alephobjects/taz-toolhead-kanyu/flexystruder/images/OHAI/IMG_0171.JPG

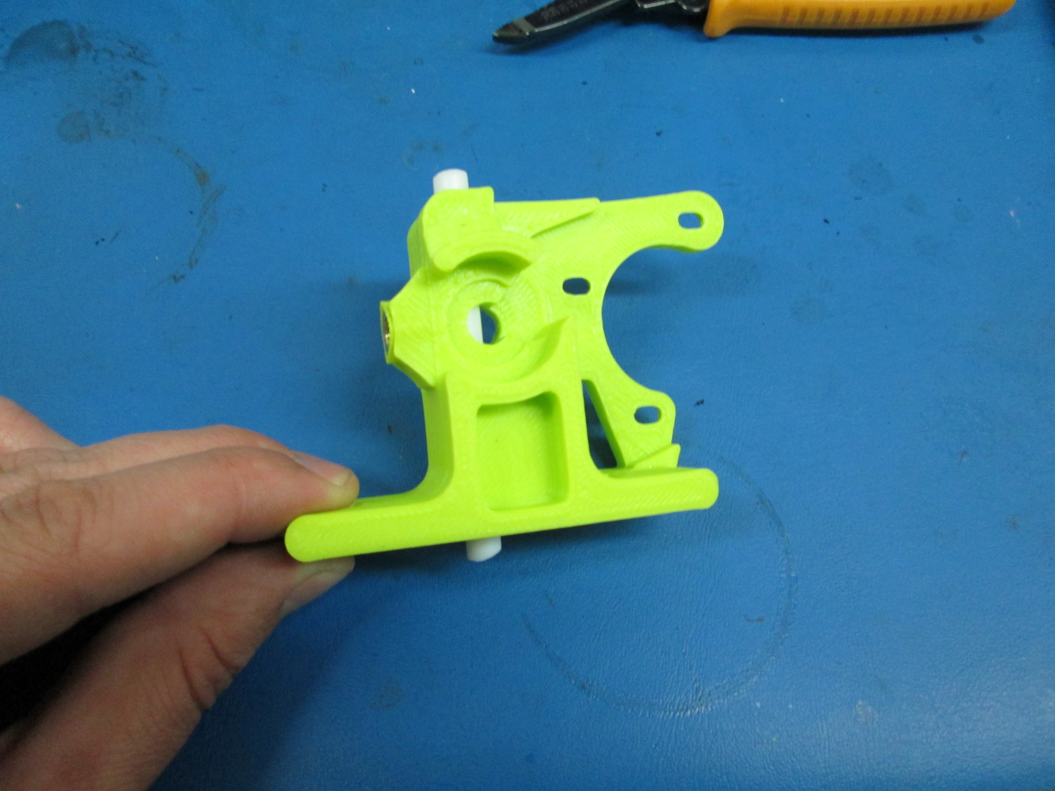
flexystruder/images/OHAI/IMG_0171.JPG
