alephobjects/taz-toolhead-kanyu/flexystruder/images/OHAI/IMG_0003.JPG.600x0_q85.jpg

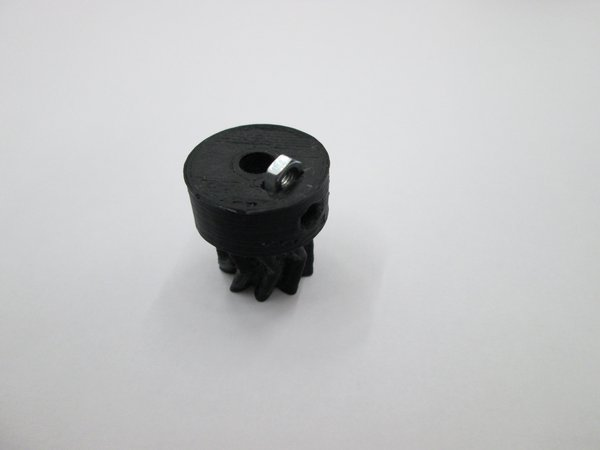
flexystruder/images/OHAI/IMG_0003.JPG.600x0_q85.jpg
