alephobjects/taz-toolhead-kanyu/production_docs/flexy_redesign_status.odt

Flexystruder redesign status

3/17/2015

Largely due to the decreased length of the melt zone between the Budashnozzle and the AO-hex, the flexystruder with the AO hexagon is only capable of printing about half as fast as the original flexystruder. For most materials the AO-hex's melt zone is long enough if the print temperatures are bumped up, but Ninjaflex presents health concerns at temperatures above 230C. Other flexible materials like Polyflex that allow for

Testing has been done on several ways to improve this speed discrepancy so that we don't release a new version that is inferior to the original. See the table below for the comparative printing speeds of the 4 options.

Flexystruder type | Maximum Speed
Budashnozzle based (current product) | 3.75 mm^3/s
Standard 0.5mm AO-Hexagon based | 1.80 mm^3/s
0.5mm AO-Hexagon with 10mm longer heater block | 3.75 mm^3/s
AO-Hexagon with 0.6mm nozzle | 3.15 mm^3/s

Option 1

We continue with the budaschnozzle as the default nozzle for the flexystruder. This would be the simplest answer, but would lead to complications for the flexydually, as the Buda and the hexagon are significantly different lengths. We could either offer the flexydually as it currently is (with a metal flex plate stiffener, or with 2 hexagons and decrease the speeds in the profiles to match.

Option 2

We could release the flexystruder with the standard 0.5mm nozzle AO-hexagon and make profiles to deal with the decerased ninjaflex printing ability. Getting polyflex on board will help a lot, we can print it 2-3X as fast as the full TPU filaments.

Option 3

We could make a new heater block and nozzle to extend the melt zone of AO-hex to the same length as the budashnozzle. This with a standard extruder could double as an E3D Volcano style hotend for large nozzle printing. Early tests showed that adding 10mm to the heater block of the AO-Hex will allow us to print at the same speeds as our current flexystruder.

Option 4

We could simply enlarge the nozzle of the AO-Hex to 0.6 (or larger). This decreases the melt and force requirements for printing TPU enough to almost match the current flexystruder in printing speed. This will decrease our minimum feature size in x and y slightly, but it would greatly increase the speed that we could print materials like polyflex with.
