alephobjects/taz-toolhead-kanyu/flexystruder/images/IMG_2415.JPG

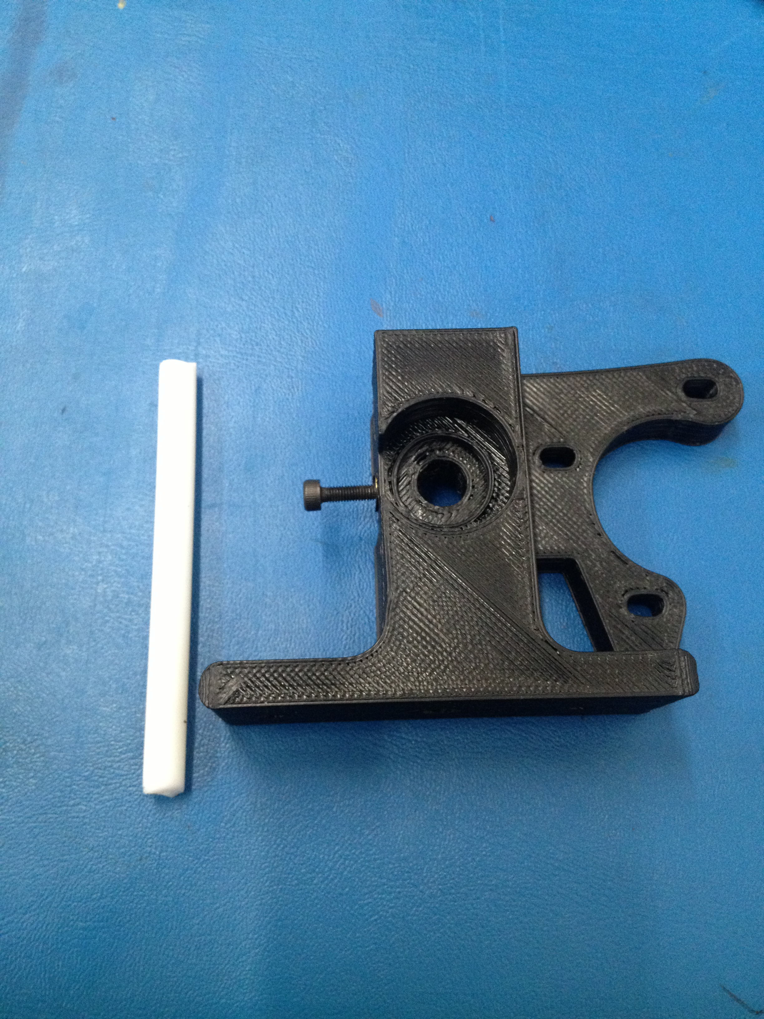
flexystruder/images/IMG_2415.JPG
