alephobjects/taz-toolhead-kanyu/flexystruder/images/IMG_2420.JPG

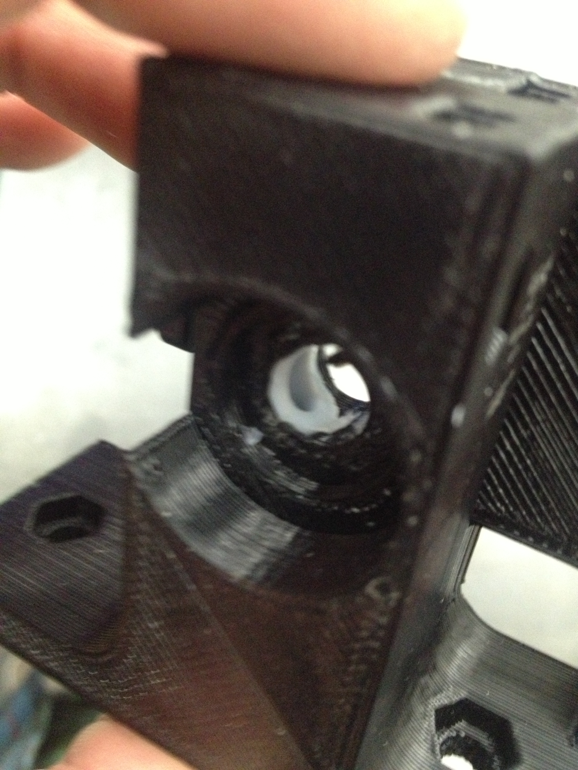
flexystruder/images/IMG_2420.JPG
