alephobjects/taz-toolhead-kanyu/flexystruder/images/IMG_2426.JPG

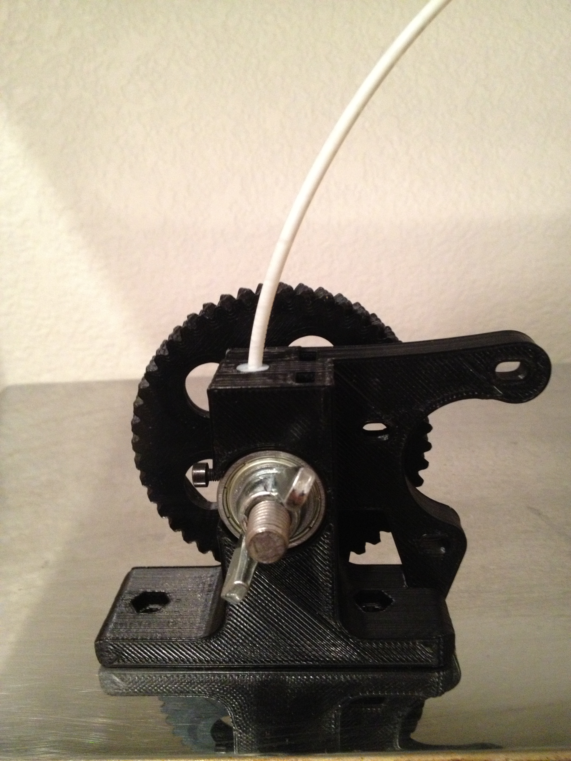
flexystruder/images/IMG_2426.JPG
