alephobjects/taz-toolhead-kanyu/flexystruder/images/IMG_2437.JPG

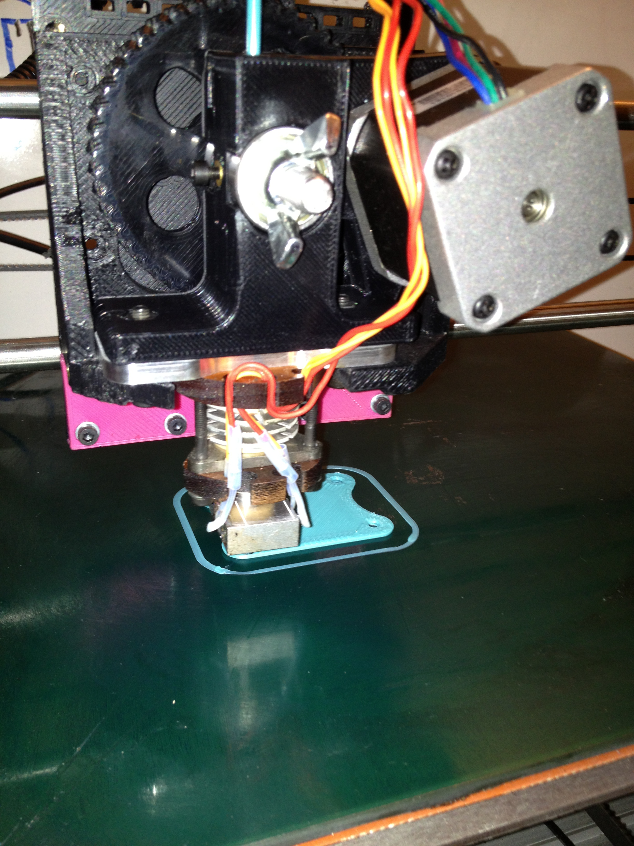
flexystruder/images/IMG_2437.JPG
