alephobjects/taz-toolhead-kanyu/flexystruder/images/OHAI/2.5mm_allen_driver.JPG.600x0_q85.jpg

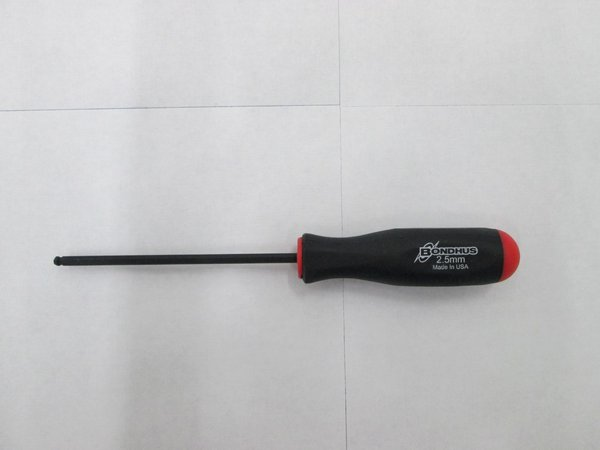
flexystruder/images/OHAI/2.5mm_allen_driver.JPG.600x0_q85.jpg
