alephobjects/taz-toolhead-kanyu/flexystruder/images/OHAI/13mm_wrench.JPG.600x0_q85.jpg

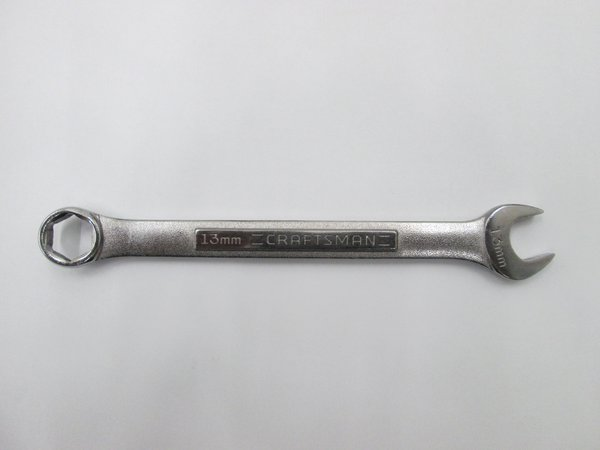
flexystruder/images/OHAI/13mm_wrench.JPG.600x0_q85.jpg
