alephobjects/taz-toolhead-kanyu/flexystruder/images/OHAI/DSC_0181.JPG.600x0_q85.jpg

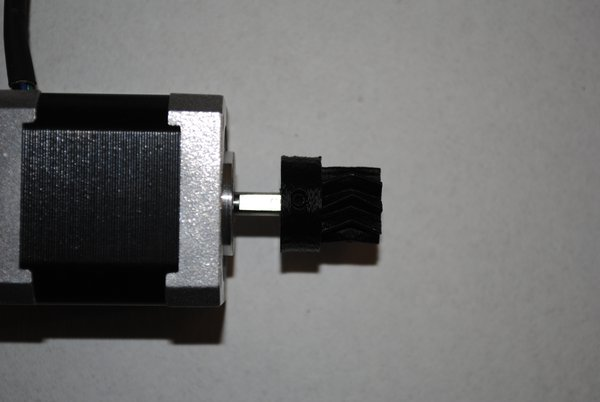
flexystruder/images/OHAI/DSC_0181.JPG.600x0_q85.jpg
