alephobjects/taz-toolhead-kanyu/flexystruder/images/OHAI/IMG_0162.JPG

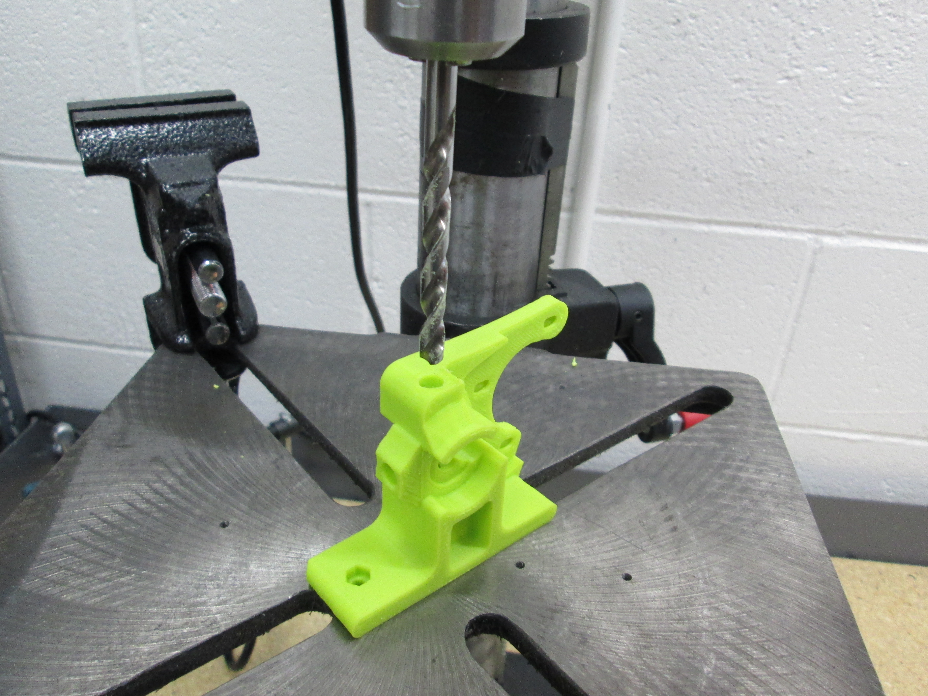
flexystruder/images/OHAI/IMG_0162.JPG
