alephobjects/taz-toolhead-kanyu/flexystruder/images/OHAI/IMG_0164.JPG

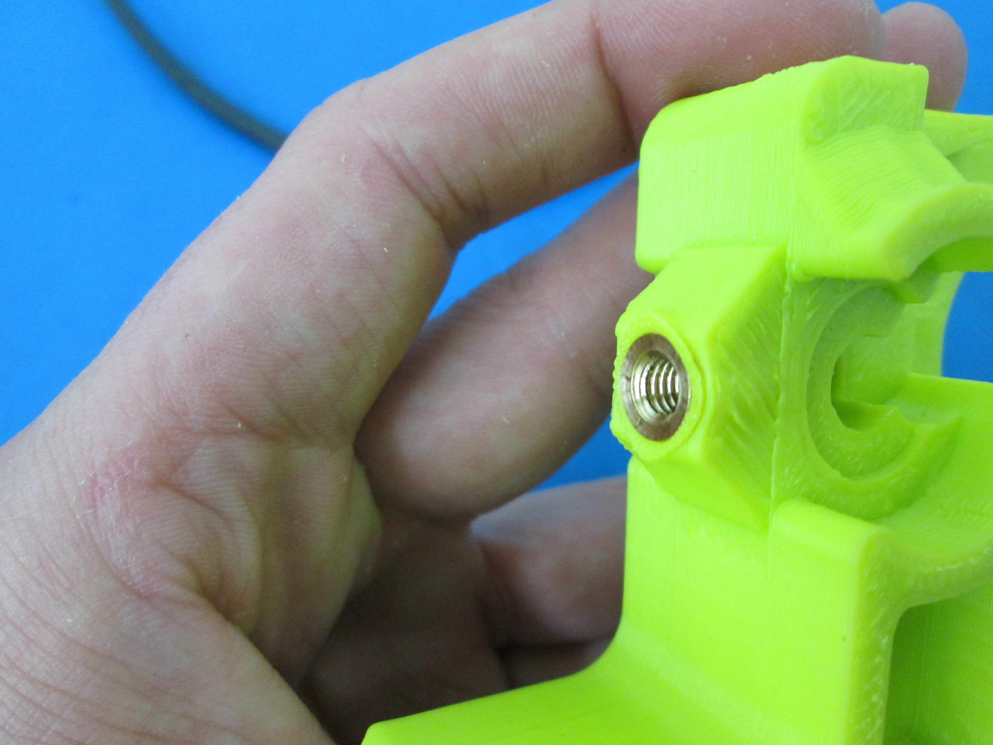
flexystruder/images/OHAI/IMG_0164.JPG
