alephobjects/taz-toolhead-kanyu/flexystruder/images/OHAI/IMG_0165.JPG

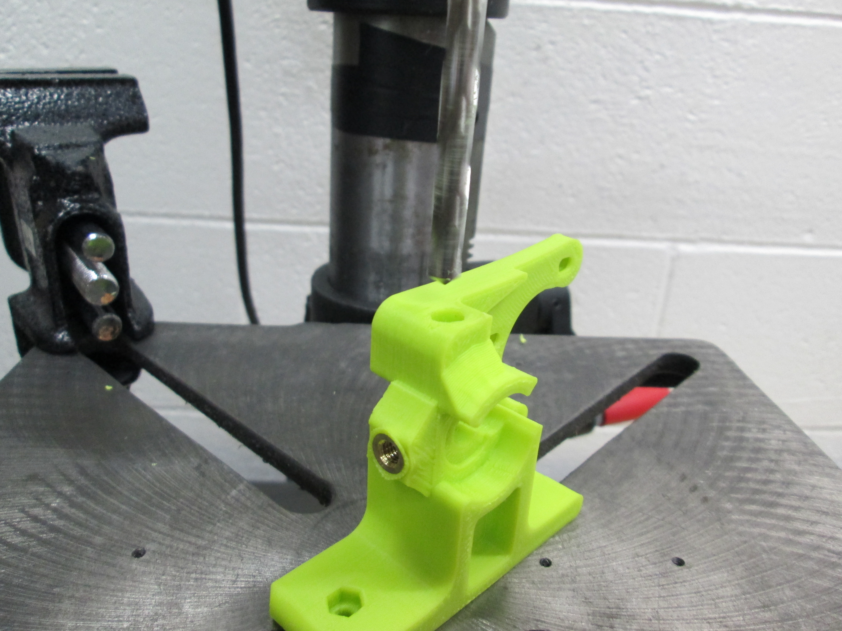
flexystruder/images/OHAI/IMG_0165.JPG
