alephobjects/taz-toolhead-kanyu/flexystruder/images/OHAI/IMG_0166.JPG

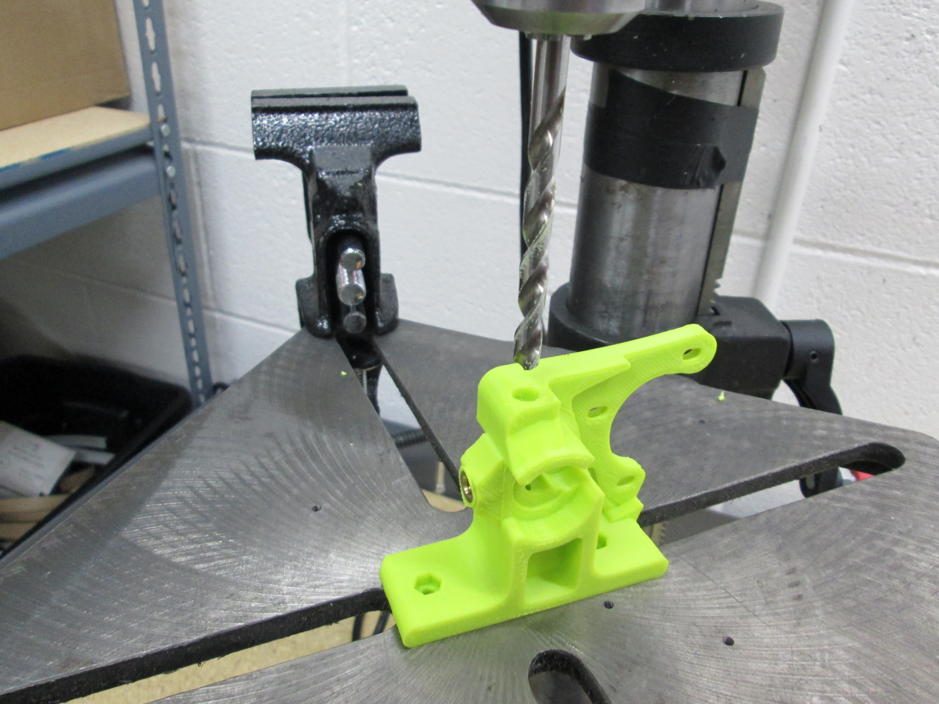
flexystruder/images/OHAI/IMG_0166.JPG
