alephobjects/taz-toolhead-kanyu/flexystruder/images/OHAI/IMG_0167.JPG

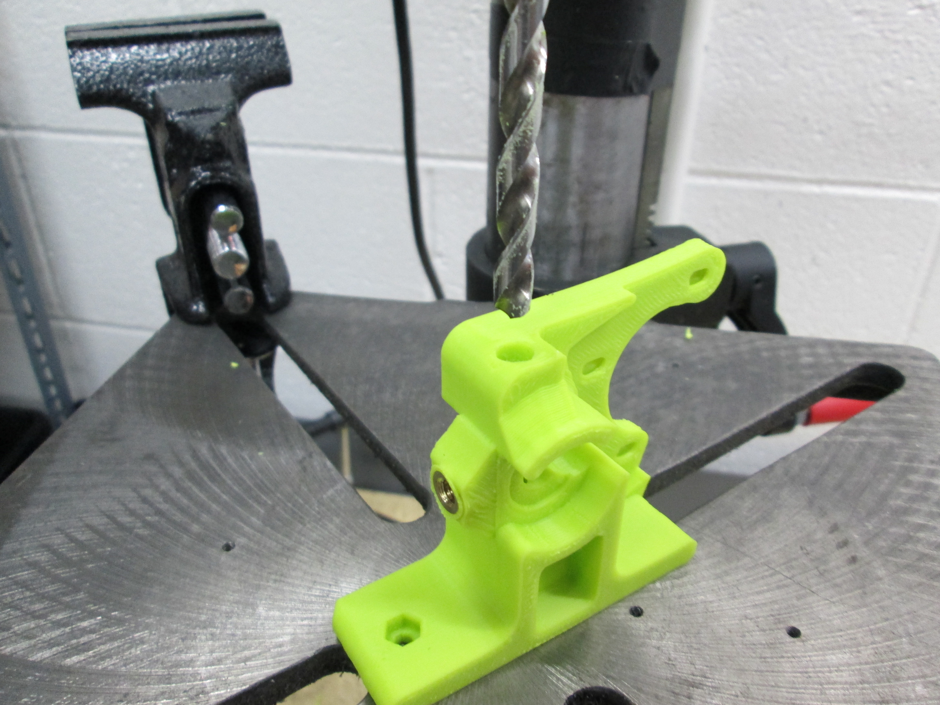
flexystruder/images/OHAI/IMG_0167.JPG
