alephobjects/taz-toolhead-kanyu/flexystruder/images/OHAI/IMG_0168.JPG

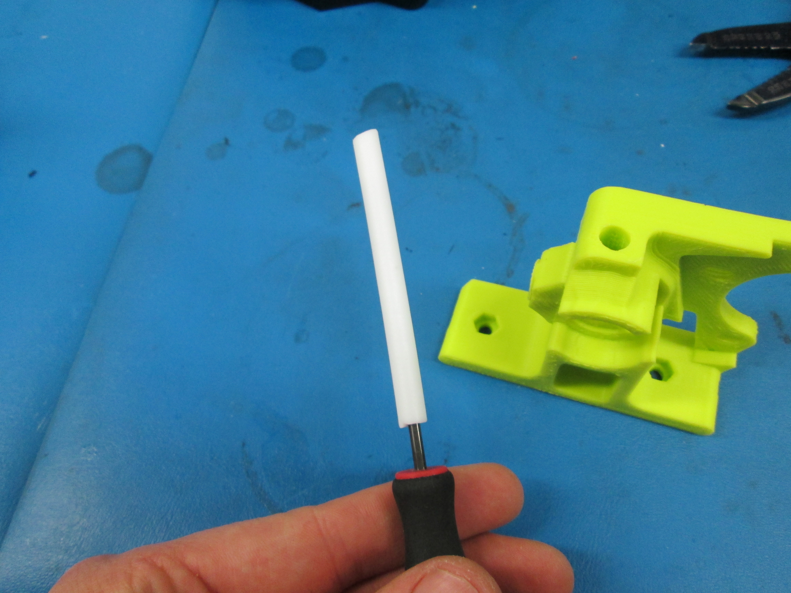
flexystruder/images/OHAI/IMG_0168.JPG
