alephobjects/taz-toolhead-kanyu/flexystruder/images/OHAI/IMG_0169.JPG

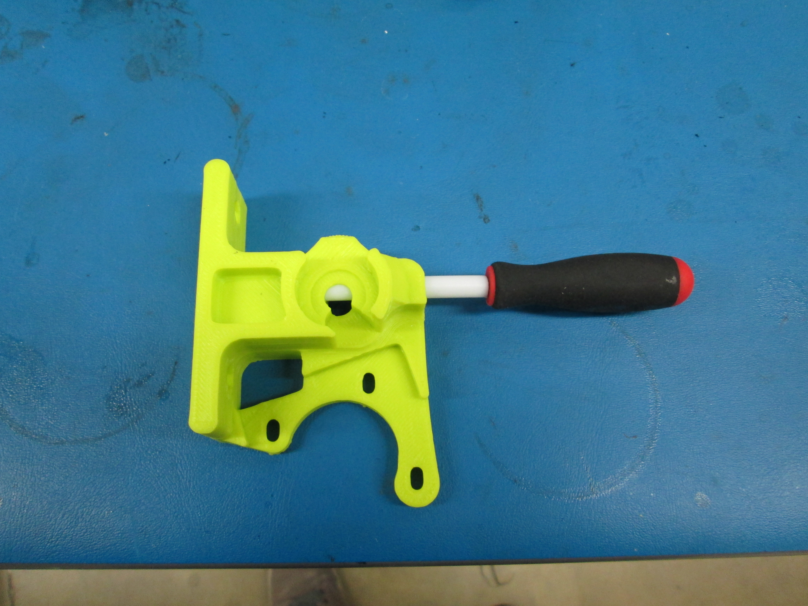
flexystruder/images/OHAI/IMG_0169.JPG
