alephobjects/taz-toolhead-kanyu/flexystruder/images/OHAI/IMG_0170.JPG

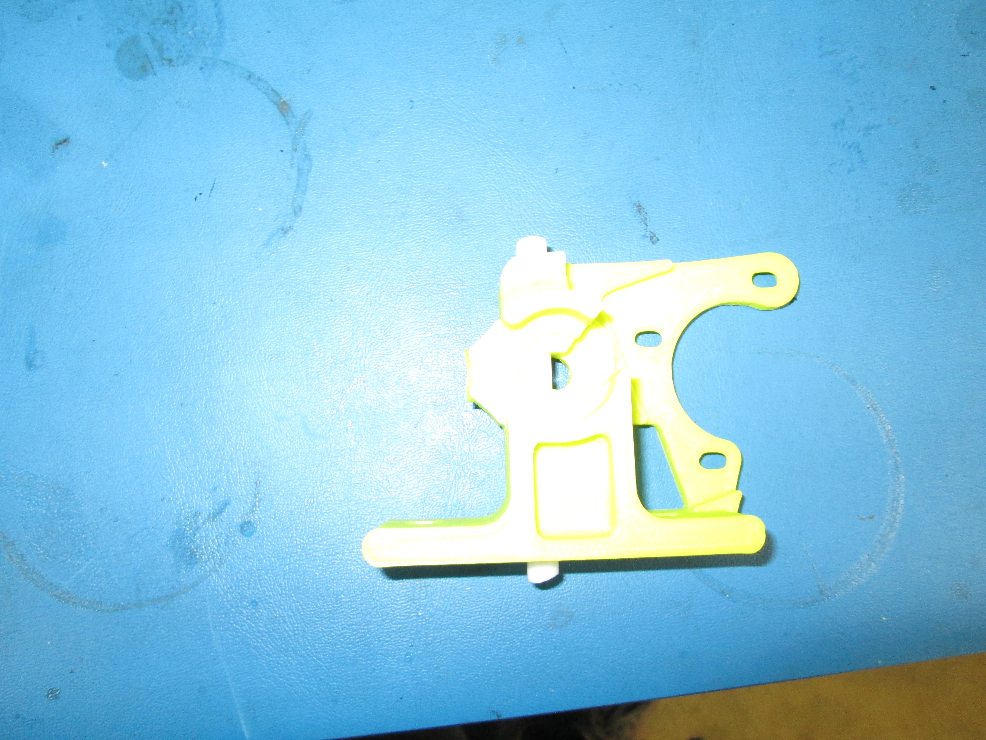
flexystruder/images/OHAI/IMG_0170.JPG
