alephobjects/taz-toolhead-kanyu/flexystruder/images/OHAI/IMG_0172.JPG

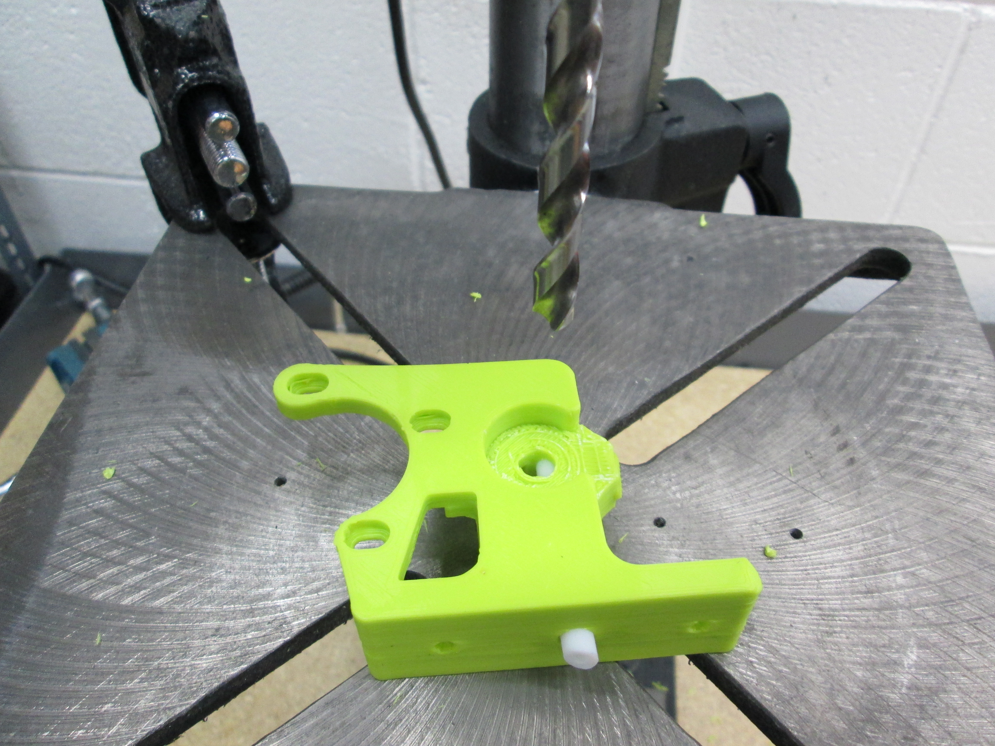
flexystruder/images/OHAI/IMG_0172.JPG
