alephobjects/taz-toolhead-kanyu/flexystruder/images/OHAI/IMG_0173.JPG

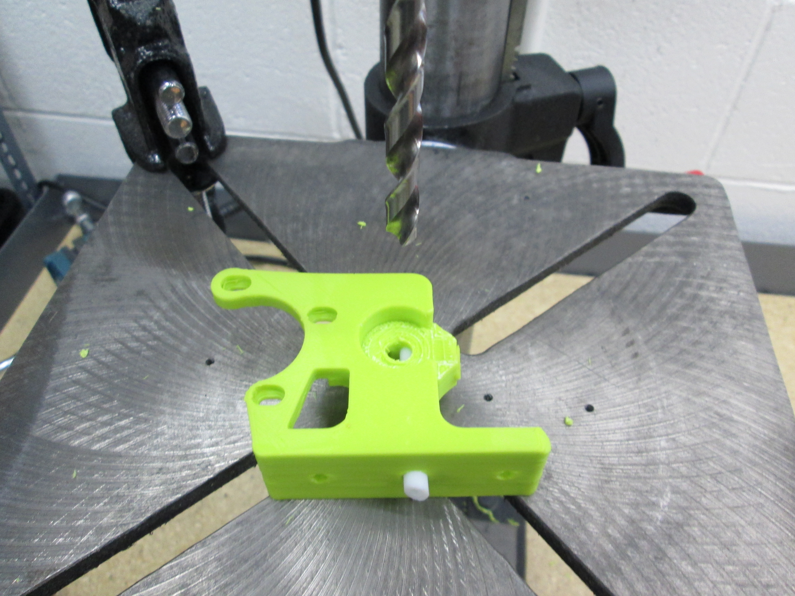
flexystruder/images/OHAI/IMG_0173.JPG
