alephobjects/taz-toolhead-kanyu/flexystruder/images/OHAI/IMG_0174.JPG

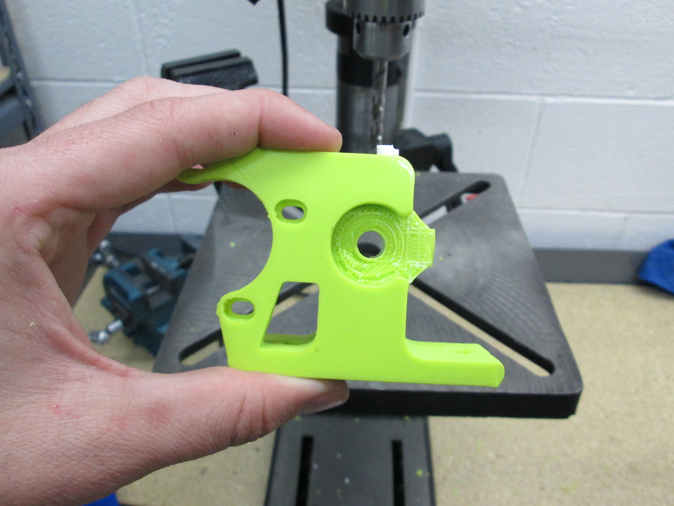
flexystruder/images/OHAI/IMG_0174.JPG
