alephobjects/taz-toolhead-kanyu/flexystruder/images/OHAI/IMG_0176.JPG

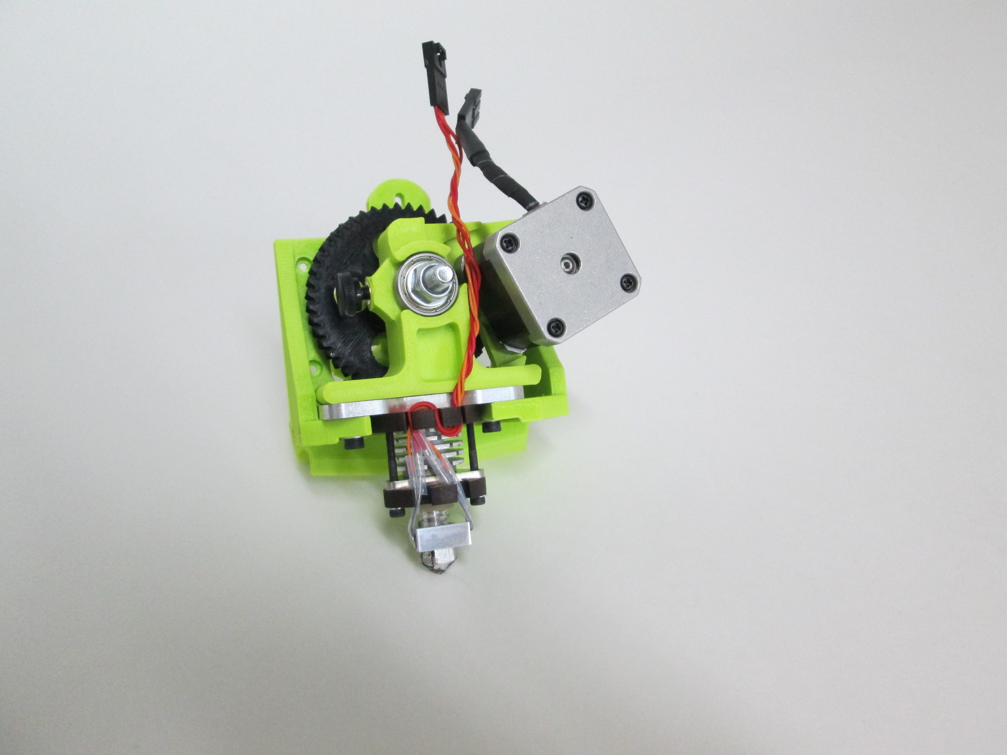
flexystruder/images/OHAI/IMG_0176.JPG
