alephobjects/taz-toolhead-kanyu/flexystruder/images/OHAI/IMG_0177.JPG

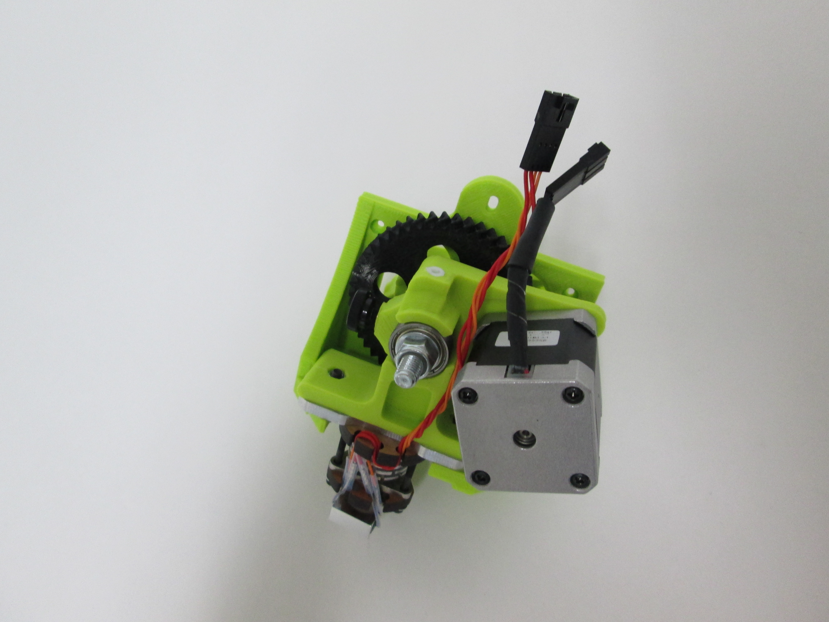
flexystruder/images/OHAI/IMG_0177.JPG
