alephobjects/taz-toolhead-kanyu/flexystruder/images/OHAI/IMG_0178.JPG

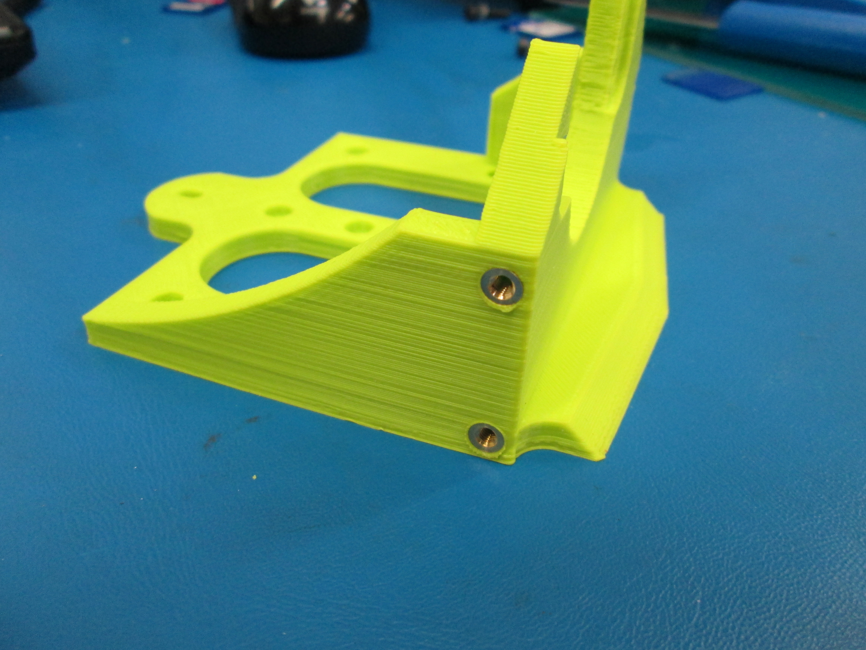
flexystruder/images/OHAI/IMG_0178.JPG
