alephobjects/taz-toolhead-kanyu/flexystruder/images/OHAI/IMG_01687.JPG

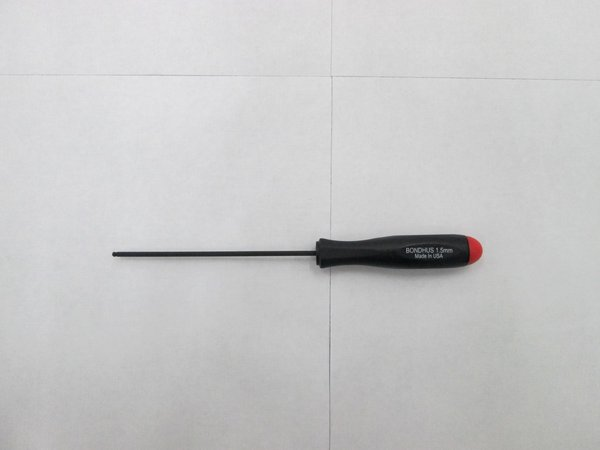
flexystruder/images/OHAI/IMG_01687.JPG
