alephobjects/taz-toolhead-kanyu/flexystruder/images/Rainbowpus.JPG

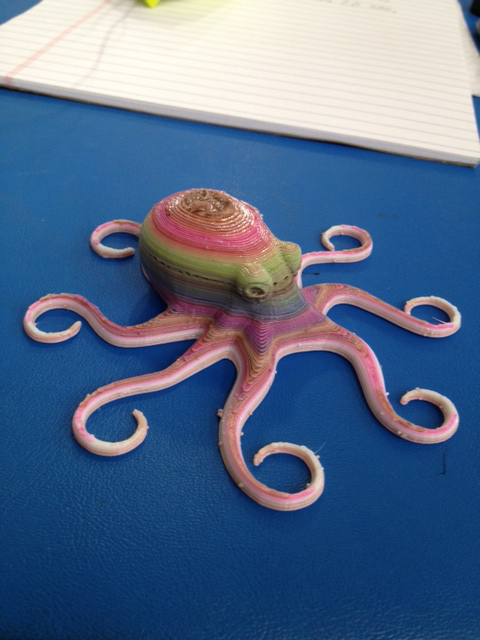
flexystruder/images/Rainbowpus.JPG
