alephobjects/taz-toolhead-kanyu/images/kanyu_hotend.png

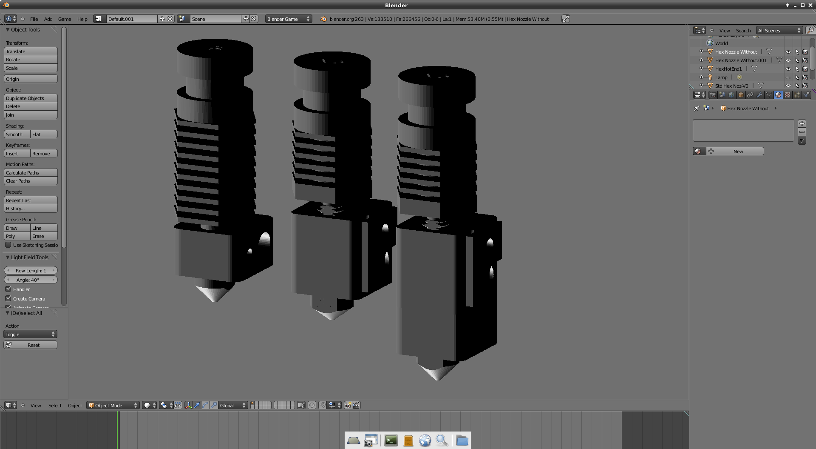
images/kanyu_hotend.png
