alephobjects/taz-toolhead-kanyu/production_parts/test_parts/extended_hex_heat block_0.15_drawing.pdf

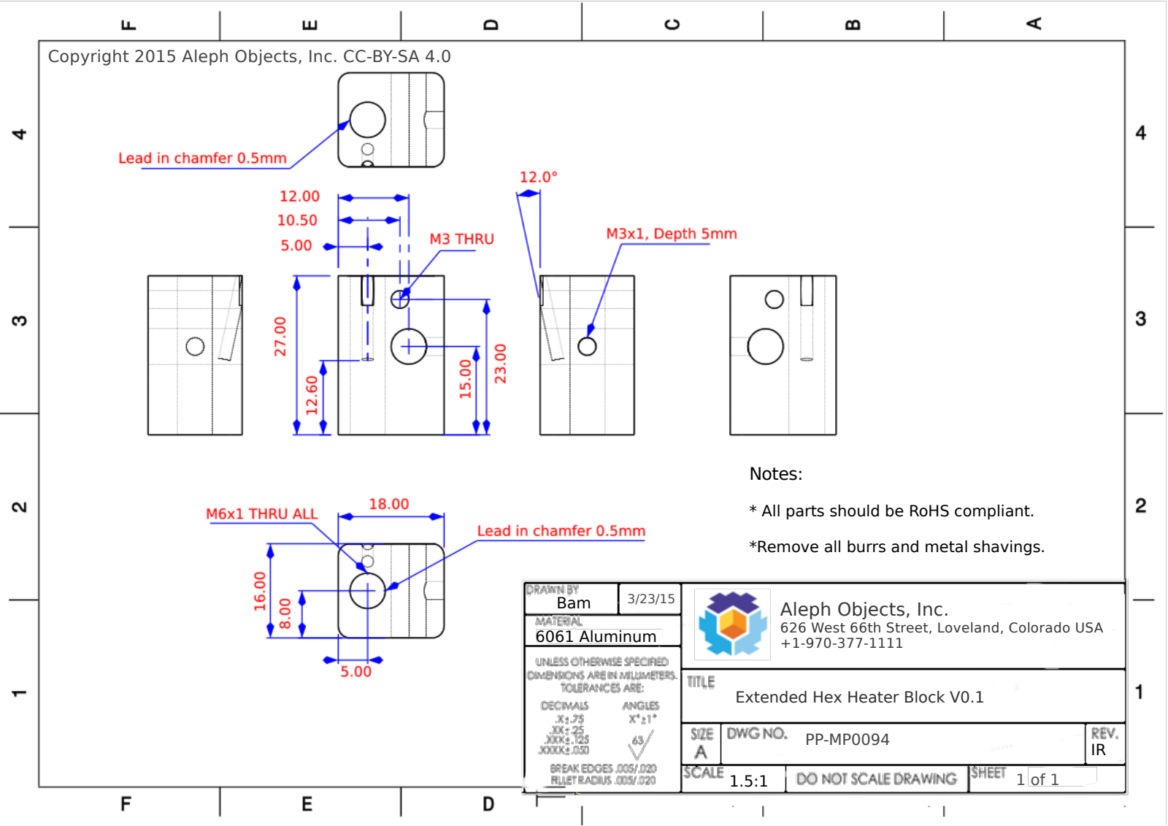
[picture p29: page 1]

Aleph Objects, Inc.
626 West 66th Street, Loveland, Colorado USA +1-970-377-1111

Copyright 2015 Aleph Objects, Inc. CC-BY-SA 4.0

3/23/15

Extended Hex Heater Block V0.1

PP-MP0094

Bam

6061 Aluminum

IR

Notes:

* All parts should be RoHS compliant.

*Remove all burrs and metal shavings.

1.5:1
