alephobjects/taz-toolhead-kanyu/production_parts/test_parts/extended_hex_nozzle_0.15_drawing.pdf

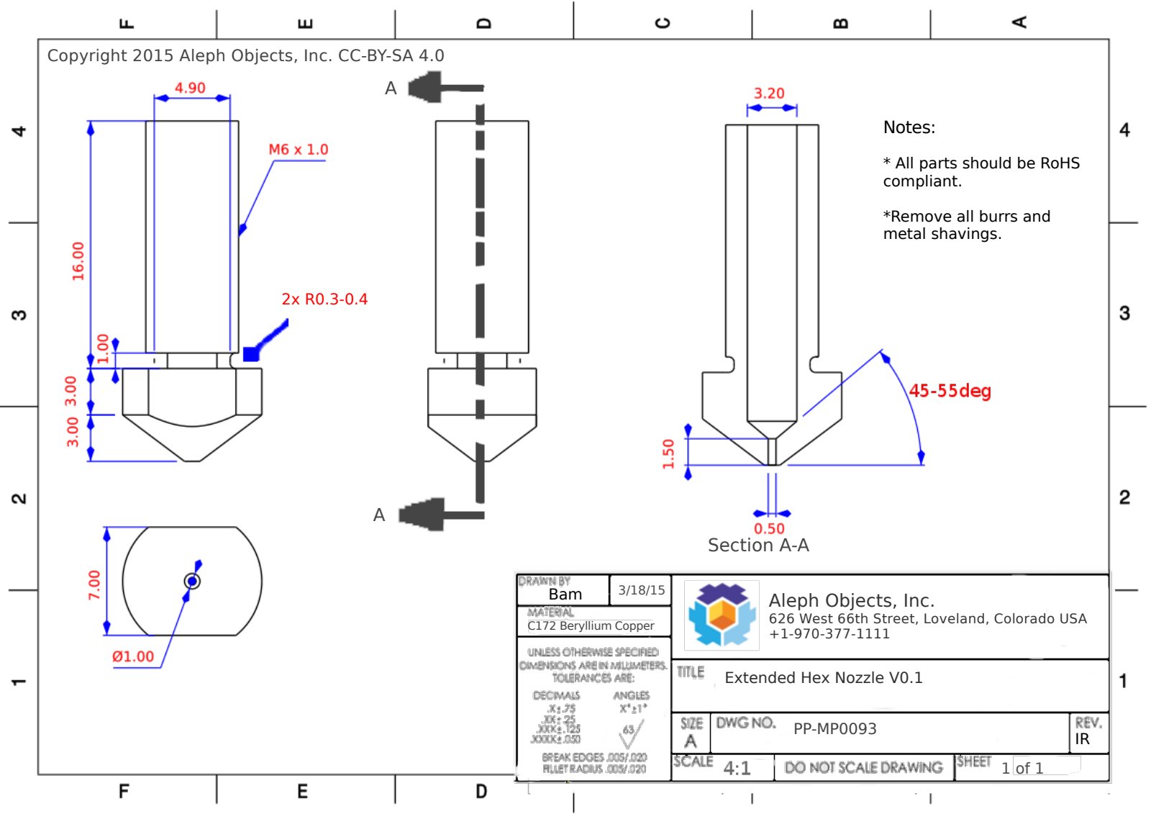
[picture p30: page 1]

2x R0.3-0.4

Notes:

* All parts should be RoHS compliant.

*Remove all burrs and
metal shavings.

A

A

Section A-A

Aleph Objects, Inc.
626 West 66th Street, Loveland, Colorado USA +1-970-377-1111

Copyright 2015 Aleph Objects, Inc. CC-BY-SA 4.0

3/18/15

Extended Hex Nozzle V0.1

PP-MP0093

Bam

C172 Beryllium Copper

IR
