alephobjects/taz-toolhead-kanyu/production_docs/kanyu_v1.0_BOM.ods

Sheet: Sheet1
AO-Hex Printhead v0.1
part | qty | Notes | AO Part No | Cost per | Cost total
Hextruder Block (body) | 1 | new |  | $4.01 | $4.01
Herringbone small gear | 1 | Red |  | $0.34 | $0.34
Herringbone large gear | 1 | Red |  | $2.34 | $2.34
Reloaded bearing washer | 1 |  | PP-GP0060 | $0.02 | $0.02
Hobbed Bolt M8x50 26mm offset | 1 |  | HD-BT0108 | $5.50 | $5.50
Extruder latch | 1 | Red |  | $0.26 | $0.26
Extruder idler block | 1 |  | PP-GP0059 | $0.90 | $0.90
Motor wires -2 | 1 |  | EL-HR0016-2 | $13.72 | $13.72
8mm smooth rod x 18-19mm, Stainless Steel | 1 |  | HD-RD0004 | $4.73 | $4.73
608 Bearing | 3 | needs to be sealed type | HD-MS0013 | $0.45 | $1.35
Extruder comp spring – music wire | 2 |  | HD-MS0027 | $0.22 | $0.44
M3 set screw | 1 |  | HD-BT0012 | $0.02 | $0.02
M3x12mm SCHS | 4 |  | HD-BT0039 | $0.01 | $0.05
M3x25 SCHS | 1 |  | HD-BT0041 | $0.03 | $0.03
M3 washer | 5 |  | HD-WA0001 | $0.00 | $0.01
M3 Nut | 2 |  | HD-NT0004 | $0.01 | $0.02
M4x55 SCHS | 2 |  | HD-BT0052 | $0.08 | $0.16
Black plastic thumbscrew for M4 | 2 |  | HD-MS0031 | $0.10 | $0.19
M4 Nut, Zinc Plated Steel | 2 |  | HD-NT0011 | $0.00 | $0.01
M4 Washer | 4 |  | HD-WA0005 | $0.00 | $0.01
M8 Nyloc Nut | 1 |  | HD-NT0002 | $0.05 | $0.05
M8 Washer, zinc plated steel | 3 |  | HD-WA0006 | $0.01 | $0.04
M8 Shim Washer, 0.5mm | 1 |  | HD-WA0008 | $0.05 | $0.05
M8 Shim Washer, 1.0mm | 1 |  | HD-WA0009 | $0.06 | $0.06
Hextruder Mount, TAZ | 1 | new |  | $6.50 | $6.50
Brass M3 heatset inserts | 4 |  | HD-MS0030 | $0.07 | $0.29
M4 Nut, Zinc Plated Steel | 2 |  | HD-NT0011 | $0.00 | $0.01
M4 washer | 2 |  | HD-WA0005 | $0.00 | $0.01
M4x20 SCHS | 2 |  | HD-BT0010 | $0.04 | $0.07
Label, Extruder E-step Number | 1 |  | DC-LB0017 | $1.00 | $1.00
Extruder Fan Mount v1.0, TAZ | 1 |  | PP-GP0153 | $1.12 | $1.12
Brass M3 heatset inserts | 4 |  | HD-MS0030 | $0.07 | $0.29
12 or 24V DC fan, 40x40x10 | 1 |  | 2 PN's | $2.50 | $2.50
Male pin, 24-30AWG tin crimp | 2 |  | EL-MS0058 | $0.00 | $0.00
Male 2 pin connector housing | 1 |  | PP-MP0059 | $0.00 | $0.00
M3 washer | 2 |  | HD-WA0001 | $0.00 | $0.00
M3x12mm SCHS | 6 |  | HD-BT0039 | $0.01 | $0.07
AO-Hex hotend kit | 1 |  |  | $24.00 | $24.00
micro blower | 1 |  |  | $8.00 | $8.00
M2 heatset insert | 1 |  | PP-MP0066 | $0.09 | $0.09
M2x6 SCHS | 1 |  |  | $0.05 | $0.05
Shipping Materials
Harness
24AWG Stranded – Red | 1000 | mm | EL-WR0103 | $0.00 | $0.26 | Digikey | C2015R-1000-ND
24AWG Stranded – Black | 1000 | mm | EL-WR0105 | $0.00 | $0.26 | Digikey | C2015B-1000-ND
14-POS, free hanging | 1 |  | EL-MS0131 | $2.51 | $2.51 | Digikey | A1358-ND
20-24 AWG Tin Pin for Plug | 2 |  | EL-MS0123 | $0.22 | $0.45 | Digikey | A31991TR-ND
Cable Clamp for 14-Pos; 0.453” opening | 1 |  | EL-MS0129 | $2.55 | $2.55 | Digikey | A32516-ND
CONN TERM FEMALE 22-24AWG TIN | 2 |  | EL-MS0059 | $0.05 | $0.10 | Digikey | WM2510-ND | Molex Inc. | 16-02-0102
CONN HOUSING 2POS .100 W/LATCH | 1 |  | PC-CN0001 | $0.13 | $0.13 | Digikey | WM2900-ND
Tubing, Corrugated Loom .25" | 960 | mm (red?) | EL-MS0073 | $0.00 | $0.92 | McMaster-Carr Supply Company | 7840K31 | Panduit | CLT25F-C20
 |  |  |  | Cost per kit | $85.47
 |  |  |  | DOES NOT INCLUDE SHIPPING MATERIALS YET

Sheet: BOM
Kanyu BOM
Category | AO Part # | Description | Manufacturer | Manufacturer PN | Distributor | Distributor SKU | Qty Per | UOM | Price Per Unit | Price Total | Qty to Order | PO | PO Date | Expected Date | Notes | Alternates
 |  |  |  |  |  |  |  |  |  |  | 500
Printed Part | PP-GP0200 | flexystruder body 2.0, for hexagon, lulzbot green |  |  | Aleph Objects Inc. |  | 1 | ea | $4.01 | $4.01 | 500
Printed Part | PP-GP0061 | herringbone_large_gear, Black |  |  | Aleph Objects Inc. |  | 1 | ea | $0.34 | $0.34 | 500
Printed Part | PP-GP0062 | herringbone_small_gear, Black |  |  | Aleph Objects Inc. |  | 1 | ea | $2.34 | $2.34 | 500
Printed Part | PP-GP0060 | Wade Reloaded Bearing Washer |  |  | Aleph Objects Inc. |  | 1 | ea | $0.02 | $0.02 | 500
Printed Part | PP-GP0202 | Extruder Mount for Hex v1.0, TAZ, lulzbot green |  |  | Aleph Objects Inc. |  | 1 | ea | $2.88 | $2.88 | 500 |  |  |  | price form ERP for standard extruder mount
Printed Part | PP-GP0153 | Extruder Fan Mount v1.0, TAZ |  |  | Aleph Objects Inc. |  | 1 | ea | $1.12 | $1.12 | 500
Electronic | EL-MS0251 | CONN HOUSING 16POS .100 DUAL | Molex |  | Heilind | WM2525-ND | 1 | ea | $0.526 | $0.53 | 500 | PO08450 | 07/20/15 | 08/11/15 | Received 13,000
Electronic | EL-MS0205 | CONN TERM MALE 22-24AWG TIN | Molex |  | Heilind | WM2517TR-ND | 9 | ea | $0.13 | $1.17 | 4500 | PO08450 | 07/20/15 | 08/11/15 | Received 13,000
Electronic | EL-MS0212 | CONN PIN 24-30AWG CRIMP TIN | Molex | 16-02-0108 | TTI | MOL16-02-0108 | 4 | ea | $0.081 | $0.32 | 2000 | PO08448 | 08/27/15 | 09/15/15 | This comes in BULK
Electronic | EL-WR0127 | Hook-up Wire 26AWG SOLID PTFE, WHT | Mouser | 602-2843/1-100-01 | Mouser | 602-2843/1-100-01 | 150 | mm | $0.000 | $0.04 | 75000 | PO08575 | 07/15/15 | 07/28/15 | 300'
Electronic | EL-FA0011 | FAN,24VDC,Sleeve,5.75CFM,40X40X10MM,60mA 6000RPM,1.44W,280MM LEADS,CE/RoHS |  |  | Kysan | TF4010-24H-S | 1 | ea | $1.45 | $1.45 | 500 | PO08435 | 07/06/15 | 08/11/15 | Received 4,000
Mechanical | HD-BT0108 | Hobbed Bolt M8x50 26mm offset |  |  | Quatro |  | 1 | ea | $4.99 | $4.99 | 500 | PO07504/07897 | 06/08/15 | See Note | Scheduled delivery of 1,000 per month
Electronic | TL-CS0083 | EMI/RFI-Shield Heat-Shrink Tubing 3/16" ID Before, 3/32" ID After, 48" L, Black |  |  | Allcable | 7937K31 | 45 | mm | $0.01 | $0.66 | 22500 | PO08449 | 07/09/15 | 07/29/15 | Received 25 x 4ft
Electronic | TL-CS0129 | Interference-Shielding Heat-Shrink Tubing, 3/8" ID Before, 3/16" ID After, 48" Long, Black |  |  | Allcable | 7937K33 | 35 | mm | $0.03 | $0.93 | 17500 | see note |  |  | We have a surplus
Electronic | EL-FA0020 | RFB2008 Micro Blower, 30 AWG wire 250mm long |  |  | Pelonis |  | 1 | ea | $6.54 | $6.54 | 500 | PO08436 | 07/06/15 | 07/31/15 | ordered for Juniperbush, extruder,retail
Hardware | HE-SH0041 | Hexagon Hotend, Lulzbot Edition, 3.0mm Filament, 0.6mm nozzle |  |  | Reprapdiscount | HE-SH0041 | 1 | ea | $23.00 | $23.00 | 500 | PO08543 | 07/17/15 | 09/22/15
Electronic | EL-MT0001 | NEMA 17 Stepper Motors |  |  | Changzhou FTX | SY42STH47-1504A | 1 | ea | $7.50 | $7.50 | 500 | PO08324 | 06/29/15 | 09/09/15 | changed from PO08066 to PO08324 (costing change)
Hardware | HD-BT0012 | M3 set screw |  |  | Fastenal |  | 1 | ea | $0.02 | $0.02 | 500 | PO08339 | 07/22/15 | 08/27/15 | received
Hardware | HD-BT0104 | M3 x 8 Bolt, BHCS, SST |  |  | Fastenal | 92095A181 | 2 | ea | $0.088 | $0.18 | 1000 | PO08339 | 07/22/15 | 08/27/15 | Received compatability add on
Hardware | HD-BT0039 | M3 x 12 Bolt, SHCS Black-Oxide |  |  | Fastenal |  | 9 | ea | $0.02 | $0.14 | 4500 | PO08339 | 07/22/15 | 08/27/15 | received
Hardware | HD-WA0001 | M3 Washer, Steel, Zinc Plated |  |  | Fastenal |  | 5 | ea | $0.02 | $0.08 | 2500 | PO08339 | 07/22/15 | 08/27/15 | received
Hardware | HD-NT0004 | M3 Nut, Zinc Plated |  |  | Fastenal |  | 1 | ea | $0.01 | $0.01 | 500 | PO08339 | 07/22/15 | 08/27/15 | received
Hardware | HD-NT0011 | M4 Nut,Zinc-Plated Steel |  |  | Fastenal |  | 2 | ea | $0.00 | $0.01 | 1000 | PO08339 | 07/22/15 | 08/27/15 | received
Hardware | HD-WA0005 | M4 Washer |  |  | Fastenal |  | 2 | ea | $0.00 | $0.01 | 1000 | PO08339 | 07/22/15 | 08/27/15 | received
Hardware | HD-NT0002 | M8 Nyloc Nut, Zinc Plated |  |  | Fastenal |  | 1 | ea | $0.03 | $0.03 | 500 | PO08339 | 07/22/15 | 08/27/15 | received
Hardware | HD-WA0006 | M8 Washer, Steel, Zinc Plated |  |  | Fastenal |  | 3 | ea | $0.02 | $0.05 | 1500 | PO08409 | 07/22/15 | 08/13/15 | received
Hardware | HD-WA0008 | Metric Spring Steel Shim - DIN 988 0.5mm Thick, 8mm ID, 14mm OD |  |  | Fastenal |  | 1 | ea | $0.05 | $0.05 | 500 | PO08409 | 07/22/15 | 08/13/15 | received
Hardware | HD-WA0009 | Metric Spring Steel Shim - DIN 988 1.0mm Thick, 8mm ID, 14mm OD |  |  | Fastenal |  | 1 | ea | $0.06 | $0.06 | 500 | PO08409 | 07/22/15 | 08/13/15 | received
Hardware | HD-MS0030 | M3-.5 3.8mm Heatset Insert |  |  | Fastenal |  | 6 | ea | $0.04 | $0.22 | 3000 | PO08576 | 07/21/15 | 08/10/15 | received
Hardware | HD-BT0010 | M4 x 20 Bolt, SHCS Black-Oxide |  |  | Fastenal |  | 2 | ea | $0.14 | $0.28 | 1000 | PO08888 | 08/05/15 | 08/07/15 | received
Hardware | PP-MP0066 | Metric Brass Heat-Set Insert for Plastics, Tapered, M2-.4 Internal Thread, 2.9MM Length |  |  | Fastenal |  | 1 | ea | $0.09 | $0.09 | 500 | PO08576 | 07/21/15 | 08/10/15 | 4-6 week lead time on these
Hardware | HD-MS0230 | M2 x 6 SHCS, Black-Oxide |  |  | Fastenal |  | 1 | ea | $0.00 | $0.00 | 500 | PO08339 | 07/15/15 | 08/27/15 | Received 4,000
Hardware | HD-MS0058 | Wire Tie, 8" |  | 63126 | Electronics Distributors Corporation |  | 1 | ea | $0.022 | $0.02 | 500 | PO8459 | 07/08/15 | 09/15/15 | Received 80,000
Consumable | TL-CS0116 | Saunders UHU Glue Stick, 0.74 oz., White |  |  | Amazon | 99649 | 1 | ea | $1.89 | $1.89 | 500 | PO10492 | 11/06/15 | 11/13/15 | Ordered 11/6/15
Consumable | TL-CS0040 | Extreme-Temperature Pipe Sealant & Threadlocker, 4 oz bottle, blue |  |  | Mcmaster | 7604A55 | 0.5 | g | $0.066 | $0.03 | 250 | PO08419 | 07/02/15 |  | received and returned because of shelve life date will order as needed Bob will let us know
Hardware | HD-TB0006 | PTFE tube, 1/4” OD x 1/8” ID, for fabrication |  |  | Mcmaster | 8547K23 | 50 | mm | $0.01 | $0.53 | 25000 | PO08594 | 07/20/15 | 07/21/15 | 165 ft 1' lengths
Electronic | EL-MS0210 | CONN RING UNINS 15-20AWG #M3 |  | 160344-2 | Digikey | A107160CT-ND | 1 | ea | $0.09 | $0.09 | 500 | PO08904 |  |  | cancelled PO we have 15 k in house (toni)
Electronic | EL-WR0040 | Wire - Single Conductor 20AWG SOLID PTFE, RED |  |  | Mouser | 602-2856/1-100-03 | 200 | mm | $0.00 | $0.78 | 100000 | PO08906 | 08/06/15 | 08/10/15 | received
Hardware | HD-WA0035 | Metric 18-8 Stainless Steel External Serrated Lock Washer, M3 Screw Size, 6mm OD, 0.4mm min Thick |  | 11511313 | Fastenal | 91120A120 | 1 | ea | $0.020 | $0.02 | 500 | PO08905 | 08/06/15 | 08/21/15 | received
Mechanical | HD-MS0282 | 608-2RS ABEC3/C3 Rubber Sealed Bearing – BLACK |  |  | JSB | 608-2RS ABEC3/C3 | 2 | ea | $0.42 | $0.84 | 1000 | PO08422 | 06/24/15 | 08/24/15 | Received 10,000 total (extruder BOMs)
Shipping | SH-PG0059 | Mailers, Indestructo, 7 x 5 x 4 |  |  | Uline | S-971 | 1 | ea | $0.76 | $0.76 | 500 | PO09761 | 09/25/15 | 09/29/15 | received
Shipping | SH-PA0019 | Bubble 1/8x48x750 perf 12" slit 2-24" rolls |  |  | Shipper Supply |  | 1 | sheet | $0.15 | $0.15 | 500 |  |  |  | not ordering recycling foam from packaging of sheet metal
Shipping | SH-PG0002 | 3 x 4" 2 Mil Reclosable Polypropylene Bags |  |  | Uline | S-1296 | 1 | ea | $0.04 | $0.04 | 500 | PO09888 | 10/07/15 | 10/16/15
 | SH-PA0039 | Roll of 48"x1/4" Thick Foam, Split at 12" - 225 feet Per Roll |  |  | Shipper Supply |  | 0.0011111111 | ea |  |  | 1 |  |  |  | not ordering recycling foam from packaging of sheet metal
Label | DC-LB0068 | Label, LulzBot TAZ Flexystruder Tool Head v2c, 0.6 Nozzle, Front |  |  | Sticker Giant |  | 1 | ea | $0.23 | $0.23 | 500 | PO09955 | 10/07/15 | 10/13/15 | Proofs approved will ship 2 business days ETA 10/13
Label | DC-LB0069 | Label, LulzBot TAZ Flexystruder Tool Head v2c, 0.6 Nozzle, Back |  |  | Sticker Giant |  | 1 | ea | $0.23 | $0.23 | 500 | PO09955 | 10/07/15 | 10/13/15 | Proofs approved will ship 2 business days ETA 10/13
Sample | RM-TE0027 | LulzBot Green NinjaFlex TPE Filament, 3mm. 0.75kg |  |  | Fenner Drives |  | 0.02 | ea | $34.41 | $0.69 |  | PO10199 |  |  | Received 12 reels
Label | DC-LB0082 | LulzBot TAZ Flexystruder v2 Serial Number Label |  |  |  |  | 1 | ea |  |  |  |  |  |  | Steven will assign sequence of Part numbers
Documentation | DC-MS0047 | v2 Tool Head Instruction Card |  |  |  |  | 1 | ea | $0.080 | $0.08 |  | PO09941 | 10/06/15 | 10/09/15
 |  |  |  |  |  |  |  |  |  | $65.42
 |  | needs approval
 |  | Added after the 1st order – sent to Toni directly

Sheet: DO NOT USE Draft Sub-assemblies
Category | AO Part # | Description |  |  | Manufacturer |  | Qty Per | UOM | Price Per Unit | Price Total
 |  | Flexystruder V2 body w/ PTFE
Printed Part | PP-GP0200 | flexystruder body 2.0, for hexagon, lulzbot green |  |  | Aleph Objects Inc. |  | 1 | ea | $4.01 | $4.01
Hardware | HD-TB0006 | PTFE tube, 1/4” OD x 1/8” ID, for fabrication |  |  | Mcmaster |  | 50 | mm | $0.01 | $0.53
 |  | Herringbone large gear sub-assembly, black
Printed Part | PP-GP0061 | herringbone_large_gear, Black |  |  | Aleph Objects Inc. |  | 1 | ea | $0.34 | $0.34
Mechanical | HD-BT0108 | Hobbed Bolt M8x50 26mm offset |  |  | Quatro |  | 1 | ea | $4.99 | $4.99
 |  | Herringbone small gear sub-assembly, black
Printed Part | PP-GP0062 | herringbone_small_gear, Black |  |  | Aleph Objects Inc. |  | 1 | ea | $2.34 | $2.34
Hardware | HD-BT0012 | M3 set screw |  |  | Fastenal |  | 1 | ea | $0.02 | $0.02
Hardware | HD-NT0004 | M3 Nut, Zinc Plated |  |  | Fastenal |  | 1 | ea | $0.01 | $0.01
 |  | Flexystruder V2 extruder body sub-assembly
 |  | Flexystruder V2 body w/ PTFE
 |  | Herringbone large gear sub-assembly, black
Printed Part | PP-GP0060 | Wade Reloaded Bearing Washer |  |  | Aleph Objects Inc. |  | 1 | ea | $0.02 | $0.02
Mechanical | HD-MS0282 | 608-2RS ABEC3/C3 Rubber Sealed Bearing – BLACK |  |  | JSB |  | 2 | ea | $0.42 | $0.84
Hardware | HD-NT0002 | M8 Nyloc Nut, Zinc Plated |  |  | Fastenal |  | 1 | ea | $0.03 | $0.03
Hardware | HD-WA0006 | M8 Washer, Steel, Zinc Plated |  |  | Fastenal |  | 3 | ea | $0.02 | $0.05
Hardware | HD-WA0008 | Metric Spring Steel Shim - DIN 988 0.5mm Thick, 8mm ID, 14mm OD |  |  | Fastenal |  | 1 | ea | $0.05 | $0.05
Hardware | HD-WA0009 | Metric Spring Steel Shim - DIN 988 1.0mm Thick, 8mm ID, 14mm OD |  |  | Fastenal |  | 1 | ea | $0.06 | $0.06
Hardware | HD-NT0011 | M4 Nut,Zinc-Plated Steel |  |  | Fastenal |  | 2 | ea | $0.00 | $0.01
 |  | NEMA 17 sub-assembly, extruder
Electronic | EL-MT0001 | NEMA 17 Stepper Motors |  |  | Changzhou FTX | SY42STH47-1504A | 1 | ea | $7.50 | $7.50
Electronic | TL-CS0083 | EMI/RFI-Shield Heat-Shrink Tubing 3/16" ID Before, 3/32" ID After, 48" L, Black |  |  | Allcable | 7937K31 | 45 | mm | $0.01 | $0.66
Electronic | TL-CS0129 | Interference-Shielding Heat-Shrink Tubing, 3/8" ID Before, 3/16" ID After, 48" Long, Black |  |  | Allcable | 7937K33 | 35 | mm | $0.03 | $0.93
Electronic | EL-MS0212 | CONN PIN 24-30AWG CRIMP TIN | Molex | 16-02-0108 | TTI | MOL16-02-0108 | 4 | ea | $0.081 | $0.32
 |  | TAZ Toolhead V2, print fan sub-assembly
Printed Part | PP-GP0153 | Extruder Fan Mount v1.0, TAZ |  |  | Aleph Objects Inc. |  | 1 | ea | $1.12 | $1.12
Electronic | EL-FA0011 | FAN,24VDC,Sleeve,5.75CFM,40X40X10MM,60mA 6000RPM,1.44W,280MM LEADS,CE/RoHS |  |  | Kysan | TF4010-24H-S | 1 | ea | $1.45 | $1.45
Hardware | HD-MS0030 | M3-.5 3.8mm Heatset Insert |  |  | CEH |  | 4 | ea | $0.04 | $0.14
Hardware | HD-BT0039 | M3 x 12 Bolt, SHCS Black-Oxide |  |  | Fastenal |  | 4 | ea | $0.02 | $0.06
Electronic | EL-MS0205 | CONN TERM MALE 22-24AWG TIN | Molex |  | Heilind | WM2517TR-ND | 2 | ea | $0.13 | $0.26
 |  | Hotend V2, 3.0mm filament, 0.6mm nozzle, sub-assembly
Hardware | HE-SH0041 | Hexagon Hotend, Lulzbot Edition, 3.0mm Filament, 0.6mm nozzle |  |  | Reprapdiscount | HE-SH0041 | 1 | ea | $23.00 | $23.00
Electronic | EL-MS0205 | CONN TERM MALE 22-24AWG TIN | Molex |  | Heilind | WM2517TR-ND | 5 | ea | $0.13 | $0.65
Electronic | EL-MS0210 | CONN RING UNINS 15-20AWG #M3 |  | 160344-2 | Digikey | A107160CT-ND | 1 | ea | $0.09 | $0.09
Electronic | EL-WR0040 | Wire - Single Conductor 20AWG SOLID PTFE, RED |  |  | Mouser | 602-2856/1-100-03 | 200 | mm | $0.00 | $0.78
Hardware | HD-WA0035 | Metric 18-8 Stainless Steel External Serrated Lock Washer, M3 Screw Size, 6mm OD, 0.4mm min Thick |  | 11511313 | Fastenal | 91120A120 | 1 | ea | $0.020 | $0.02
Consumable | TL-CS0040 | Extreme-Temperature Pipe Sealant & Threadlocker, 4 oz bottle, blue |  |  | Mcmaster | 7604A55 | 0.5 | g | $0.066 | $0.03
 |  | Extruder V2 microblower sub-assembly
Electronic | EL-FA0020 | RFB2008 Micro Blower, 30 AWG wire 250mm long |  |  | Pelonis |  | 1 | ea | $6.54 | $6.54
Electronic | EL-MS0212 | CONN PIN 24-30AWG CRIMP TIN | Molex | 16-02-0105 | TTI | MOL16-02-0108 | 2 | ea | $0.036 | $0.07
 |  | TAZ Flexystruder V2 extruder mount sub-assembly
Printed Part | PP-GP0202 | Extruder Mount for Hex v1.0, TAZ, lulzbot green |  |  | Aleph Objects Inc. |  | 1 | ea | $2.88 | $2.88
Hardware | HD-MS0030 | M3-.5 3.8mm Heatset Insert |  |  | Fastenal |  | 2 | ea | $0.04 | $0.07
Hardware | PP-MP0066 | Metric Brass Heat-Set Insert for Plastics, Tapered, M2-.4 Internal Thread, 2.9MM Length |  |  | Fastenal |  | 1 | ea | $0.09 | $0.09
 |  | TAZ Flexystruder V2 tool head final sub-assembly
 |  | Flexystruder V2 extruder body sub-assembly
 |  | Herringbone small gear sub-assembly, black
 |  | NEMA 17 sub-assembly, extruder
 |  | Toolhead V2, print fan sub-assembly
 |  | Hotend V2, 3.0mm filament, 0.6mm nozzle, sub-assembly
 |  | Extruder V2 microblower sub-assembly
 |  | Flexystruder V2 extruder mount sub-assembly
Electronic | EL-MS0251 | CONN HOUSING 16POS .100 DUAL | Molex |  | Heilind | WM2525-ND | 1 | ea | $0.526 | $0.53
Hardware | HD-BT0039 | M3 x 12 Bolt, SHCS Black-Oxide |  |  | Fastenal |  | 5 | ea | $0.02 | $0.08
Hardware | HD-WA0001 | M3 Washer, Steel, Zinc Plated |  |  | Fastenal |  | 5 | ea | $0.02 | $0.08
Hardware | HD-WA0005 | M4 Washer |  |  | Fastenal |  | 2 | ea | $0.00 | $0.01
Hardware | HD-BT0010 | M4 x 20 Bolt, SHCS Black-Oxide |  |  | Fastenal |  | 2 | ea | $0.14 | $0.28
Hardware | HD-MS0230 | M2 x 6 SHCS, Black-Oxide |  |  | Fastenal |  | 1 | ea | $0.00 | $0.00
Shipping | HD-MS0348 | ESD Foam 40mm x 20mm x 10mm - Extruder Pin Protector |  |  | Paqsource | 015-29146 | 1 | ea | $0.03 | $0.03
Hardware | HD-MS0058 | Wire Tie, 8" |  | 63126 | Electronics Distributors Corporation |  | 1 | ea | $0.022 | $0.02
Label | DC-LB0082 | LulzBot TAZ Flexystruder v2 Serial Number Label |  |  |  |  | 1 | ea
 |  | Flexystruder V2 accessory kit
Shipping | SH-PG0002 | 3 x 4" 2 Mil Reclosable Polypropylene Bags |  |  | Uline | S-1296 | 1 | ea | $0.04 | $0.04
Consumable | TL-CS0117 | Elmer's Glue Sticks, .77oz |  |  | Dick Blick Art Materials | 23810-1020 | 1 | ea | $1.30 | $1.30
Sample | RM-TE0027 | LulzBot Green NinjaFlex TPE Filament, 3mm. 0.75kg |  |  | Fenner Drives |  | 0.02 | ea | $34.41 | $0.69
 | KT-CP0090 | TAZ LulzBot TAZ Flexystruder Tool Head V2
 |  | Flexystruder V2 tool head final sub-assembly
Shipping | SH-PG0059 | Mailers, Indestructo, 7 x 5 x 4 |  |  | Uline | S-971 | 1 | ea | $0.76 | $0.76
Shipping | SH-PA0019 | Bubble 1/8x48x750 perf 12" slit 2-24" rolls |  |  | Shipper Supply |  | 1 | sheet | $0.15 | $0.15
 | SH-PA0039 | Roll of 48"x1/4" Thick Foam, Split at 12" - 225 feet Per Roll |  |  | Shipper Supply |  | 0.0011111111 | ea
Label | DC-LB0068 | Label, LulzBot TAZ Flexystruder Tool Head v2c, 0.6 Nozzle, Front |  |  | Sticker Giant |  | 1 | ea | $0.23 | $0.23
Label | DC-LB0069 | Label, LulzBot TAZ Flexystruder Tool Head v2c, 0.6 Nozzle, Back |  |  | Sticker Giant |  | 1 | ea | $0.23 | $0.23
Documentation | DC-MS0047 | v2 Tool Head Instruction Card |  |  |  |  | 1 | ea | $0.080 | $0.08
 |  | Flexystruder V2 accessory kit
