alephobjects/taz-toolhead-kanyu/flexystruder/flexystruder-1.0/Flexystruder-V1.0-BOM.ods

Sheet: Costed BOM
Category | Status | AO Part # | Description | Manufacturer | Manufacturer PN | Distributor | Distributor SKU | Qty Per | UOM | Price Per Unit | Price Total | Comment | Lead Time (wks) | Responsible | To Order | Notes
Printed |  | PP-GP0166 | Flexystruder Body V1.1 | Aleph Objects |  | Aleph Objects |  | 1 | ea
Printed |  | PP-GP0061 | herringbone_large_gear | Aleph Objects |  | Aleph Objects |  | 1 | ea | $0.56 | $0.56 | extruder | 4
Printed |  | PP-GP0062 | herringbone_small_gear | Aleph Objects |  | Aleph Objects |  | 1 | ea | $0.08 | $0.08 | extruder | 4
Printed |  | PP-GP0096 | Extruder mount, TAZ | Aleph Objects |  | Aleph Objects | X_SingleExtruderMount.stl | 1 | ea | $1.43 | $1.43 |  | 4
Printed |  | PP-GP0060 | Wade Reloaded Bearing Washer | Aleph Objects |  | Aleph Objects |  | 1 | ea | $0.00 | $0.00 | extruder | 4
Hardware |  | HD-NT0004 | M3 Nut, Zinc Plated QTY UPDATED FROM 8 TO 16 PER; BARRY & MARK 1-13-14 |  |  | Timberline |  | 1 | ea | $0.01 | $0.01 | small herringbone gear, extruder idler | 1 |  |  | McMaster-Carr Supply Company | 90591A121
Hardware |  | HD-BT0012 | M3 Set Screw (Grub Screw) |  |  | Timberline |  | 1 | ea | $0.02 | $0.02 | extruder, rods and switches | 1 |  |  | McMaster-Carr Supply Company | 91390A100
Hardware |  | HD-MS0030 | M3-.5 3.8mm Heatset Insert |  |  | Timberline |  | 4 | ea | $0.07 | $0.27 |  | 1 |  |  | McMasterCarr | 94180A331
Hardware |  | HD-BT0044 | M3 x 5 Bolt, SHCS Black-Oxide |  |  | Timberline |  | 3 | ea | $0.06 | $0.18 | RAMBo board | 1 |  |  | McMaster-Carr Supply Company | 91290A110
Hardware |  | HD-WA0001 | M3 Washer, Steel, Zinc Plated |  |  | Timberline |  | 3 | ea | $0.00 | $0.00 |  | 1 |  |  | McMaster-Carr Supply Company | 91166A210
Hardware |  | HD-BT0010 | M4 x 20 Bolt, SHCS Black-Oxide |  |  | Timberline |  | 2 | ea | $0.04 | $0.07 | Extruder/Buda | 1 |  |  | McMaster-Carr Supply Company | 91290A168
Hardware |  | HD-WA0005 | M4 Washer |  |  | Timberline |  | 2 | ea | $0.00 | $0.01 | Extruder/Buda | 1 |  |  | McMaster-Carr Supply Company | 91166A230
Hardware |  | HD-NT0011 | M4 Nut,Zinc-Plated Steel |  |  | Timberline |  | 2 | ea | $0.01 | $0.02 | extruder/buda | 1 |  |  | McMaster-Carr Supply Company | 90591A141
Hardware |  | HD-BT0028 | Hobbed, M8 x 60 Hex Head Bolt |  |  | Loveland Screw Machine |  | 1 | ea | $4.00 | $4.00 | extruder | 3 |  |  | See LSM Quote
Hardware |  | HD-NT0002 | M8 Nyloc Nut, Zinc Plated |  |  | Timberline |  | 1 | ea | $0.05 | $0.05 | bearings, extruder | 1 |  |  | McMaster-Carr Supply Company | 90576A117
Hardware |  | HD-WA0006 | M8 Washer, Steel, Zinc Plated |  |  | Timberline |  | 5 | ea | $0.01 | $0.06 | extruder, spooler,bearings | 1 |  |  | McMaster-Carr Supply Company | 91166A270
Mechanical |  | HD-MS0013 | 608ZZ bearing |  |  | vxb.com | 100Skate | 2 | ea | $0.21 | $0.42 | 4 bearings used in robot, 3 in extruder | 2 |  |  | Received
Hardware |  | HD-MS0060 | M5-.8 11mm Heatset Insert |  |  | Timberline |  | 1 | ea | $0.22 | $0.22 | 4 reqd | 1 |  |  | McMasterCarr | 94180A363
Hardware |  | HD-BT0049 | M5 x 14 Bolt, SHCS Black_Oxide |  |  | Timberline |  | 1 | ea | $0.03 | $0.03 | If required threading into the end of an extrusion | 1 |  |  | Mcmaster-Carr Supply Company | 91290A230
Hardware |  | HD-MS0055 | Thumb Screw Knob for M5 SHCS, Black |  |  | Timberline |  | 1 | ea | $0.11 | $0.11 | Y-axis | 1 |  |  | McMaster-Carr Supply Company | 91175A063
Hardware |  |  | .25”ODx.125”ID PTFE tube (~2.5”) |  |  | McMaster-Carr Supply Company | 8547K23 | 1
Mechanical |  | HE-SH0016 | Assy, Budaschnozzle 2.0c with 0.35 nozzle | Aleph Objects |  | Aleph Objects |  | 1 | ea | $52.00 | $52.00 |  | 4
Pre-assembled Electronics |  | EL-HR0016-2 | Motor wires -2 |  |  | RPC |  | 1 | ea | $11.65 | $11.65 |  | 3
 |  |  | NEMA 17 Stepper Motor
 |  |  | 4 pin socket connector housing
 |  |  | male connector pins
 |  |  | Might Change
 |  |  | Will Change

Sheet: Sub-Assemblies
Category | Status | AO Part # | Description | Manufacturer | Manufacturer PN | Distributor | Distributor SKU | Qty Per | UOM | Price Per Unit | Price Total | Comment | Lead Time (wks) | Responsible | To Order | Notes
Motor Extension -1 |  | EL-HR0017-1 |  |  |  |  |  | 1 |  |  | $6.34 |  | 4
Electronic |  |  | Connector Crimp, Female | Molex Inc. | 16-02-0102 | Digikey | WM2510-ND | 8 | ea | $0.05 |  |  | 1 | Seth |  | Digikey for 1000 pc qty, 81825 in stock
Electronic |  |  | Connector, 4 pin Female housing with latch | Molex | 50579404 | Digikey | WM2902-ND | 2 | ea | $0.29 |  |  | 1 | Seth |  | Digikey, 24663 in stock
Electronic |  |  | CONN RING UNINS 15-20AWG #M3 |  |  | Digikey | A107160CT-ND | 1 | ea | 0.10672
Electronic |  |  | 22AWG multi-conductor shielded cable with ground wire |  |  |  |  | 400 | mm | 0.01
Labor+non-supplies electroinics |  |  | Labor |  |  | RPC |  | 1 | ea | 0.01 | $6.34 | 6.34
Motor Extension -2 |  | EL-HR0017-2 |  |  |  |  |  | 1 |  |  | $6.59 |  | 4
Electronic |  |  | Connector Crimp, Female | Molex Inc. | 16-02-0102 | Digikey | WM2510-ND | 8 | ea | $0.05
Electronic |  |  | Connector, 4 pin Female housing with latch | Molex | 50579404 | Digikey | WM2902-ND | 2 | ea | $0.29
Electronic |  |  | CONN RING UNINS 15-20AWG #M3 |  |  | Digikey | A107160CT-ND | 1 | ea | 0.10672
Electronic |  |  | 22AWG multi-conductor shielded cable with ground wire |  |  |  |  | 470 | mm | 0.01
Labor+non-supplies electroinics |  |  | Labor |  |  | RPC |  | 1 | ea | 0.01 | $6.59 | 6.59
Motor Extension -3 |  | EL-HR0017-3 |  |  |  |  |  | 1 |  |  | $6.64 |  | 4
Electronic |  |  | Connector Crimp, Female | Molex Inc. | 16-02-0102 | Digikey | WM2510-ND | 8 | ea | $0.05
Electronic |  |  | Connector, 4 pin Female housing with latch | Molex | 50579404 | Digikey | WM2902-ND | 2 | ea | $0.29
Electronic |  |  | CONN RING UNINS 15-20AWG #M3 |  |  | Digikey | A107160CT-ND | 1 | ea | 0.10672
Electronic |  |  | 22AWG multi-conductor shielded cable with ground wire |  |  |  |  | 590 | mm | 0.01
Labor+non-supplies electroinics |  |  | Labor |  |  | RPC |  | 1 | ea | 0.01 | $6.64 | 6.64
Motor Extension -4 |  | EL-HR0017-4 |  |  |  |  |  | 1 |  |  | $7.63 |  | 4
Electronic |  |  | Connector Crimp, Female | Molex Inc. | 16-02-0102 | Digikey | WM2510-ND | 8 | ea | $0.05
Electronic |  |  | Connector, 4 pin Female housing with latch | Molex | 50579404 | Digikey | WM2902-ND | 2 | ea | $0.29
Electronic |  |  | CONN RING UNINS 15-20AWG #M3 |  |  | Digikey | A107160CT-ND | 1 | ea | 0.10672
Electronic |  |  | 22AWG multi-conductor shielded cable with ground wire |  |  |  |  | 1300 | mm | 0.01
Labor+non-supplies electroinics |  |  | Labor |  |  | RPC |  | 1 | ea | 0.01 | $7.63 | 7.63
Motor Wires -1 |  | EL-HR0016-1 |  |  |  |  |  | 1 |  |  | $12.30 |  | 4
Electronic |  |  | NEMA 17 Stepper Motors, wires cut to 100mm |  |  | Soyo | SY42STH47-1504A | 1 | ea | $7.78 | $7.78
Electronic |  |  | Connector Crimp, Female | Molex Inc. | 16-02-0102 | Digikey | WM2510-ND | 4 | ea | $0.05
Electronic |  |  | Connector, 4 pin Female housing with latch | Molex | 50579404 | Digikey | WM2902-ND | 1 | ea | $0.29
Electronic |  |  | EMI/RFI-Shield Heat-Shrink Tubing 3/16" ID Before, 3/32" ID After, 48" L, Black, cut to 90mm |  |  | Mcmaster-Carr Supply Company | 7937K31 | 90 | mm | $0.01
Labor+non-supplies electroinics |  |  |  |  |  | RPC |  | 1 | ea | 0.01 | $4.52 | 4.52
Motor Wires -2 |  | EL-HR0016-2 |  |  |  |  |  | 4 |  |  | $11.65 |  | 4
Electronic |  |  | NEMA 17 Stepper Motors, wires cut to 60mm |  |  | Soyo | SY42STH47-1504A | 1 | ea | $7.78 | $7.78
Electronic |  |  | Connector Pins, Male | Molex | 16-02-0108 | Digikey | WM2565-ND | 4 | ea | $0.11
Electronic |  |  | Connector, 4 pin Male housing with latch | Molex | 701070003 | Digikey | WM2535-ND | 1 | ea | $0.51
Electronic |  |  | EMI/RFI-Shield Heat-Shrink Tubing 3/16" ID Before, 3/32" ID After, 48" L, Black, cut to 50mm |  |  | Mcmaster-Carr Supply Company | 7937K31 | 50 | mm | $0.01
Labor+non-supplies electroinics |  |  |  |  |  | RPC |  | 1 | ea | 0.01 | $3.87 | 15.48
Power Supply Assembly |  | EL-HR0020 |  |  |  |  |  | 1 |  |  | $56.88 |  | 4
Electronic |  | EL-PS0014 | Power Supply 24V, 15A |  |  | Shenzhen | S-360-12 | 1 | ea | $17.10 | $17.10
Electronic |  |  | CONN PLUG CPC 4POS STD SER 1 |  |  | Digikey | A1300-ND | 1 | ea | $3.28
Electronic |  |  | CONN CABLE CLAMP CPC SIZE 11 BLK |  |  | Digikey | A32515-ND | 1 | ea | $4.86
Electronic |  |  | CONTACT SKT 14-18AWG CRIMP TIN |  |  | Digikey | 1-66360-6-ND | 4 | ea | $0.36
Electronic |  |  | AC Power Entry Modules SC MT FUSED .25" TAB |  |  | Mouser | 161-PF0030/63 | 1 | ea | $4.50
Electronic |  |  | Rocker Switches & Paddle Switches POWER ROCKER |  |  | Mouser | 506-PRBSA1-16F-BB0HW | 1 | ea | $1.73
Electronic |  |  | Fuses 125V 7A 5X20 MA UL LBC |  |  | Mouser | 576-0233007.MXP | 2 | ea | $0.71
Electronic |  |  | Conn, Crimp, .250, 14-16AWG | TE Connectivity | 3-350820-2 | Digikey | A27824-ND | 5 | ea | $0.19
Electronic |  |  | Wire, Red, 16AWG Stranded |  |  | Mcmaster-Carr Supply Company | 7587K962 | 2180 | mm | $0.00
Electronic |  |  | Wire, Yellow, 16AWG Stranded |  |  | McMaster-Carr Supply Company | 7587K963 | 2080 | mm | $0.00
Electronic |  |  | Wire - Single Conductor 16AWG Purple, 100' |  |  | Mcmaster-Carr Supply Company | 7587K079 | 80 | mm | $0.00
Hardware |  |  | Wire Tubing (100' roll) | Panduit | CLT25F-C20 | Digikey | 298-1141-ND | 1000 | mm | $0.00
Hardware |  | HD-BT0056 | Class 10.9 STL Button Head Socket Cap Screw M4 Size, 8 mm Length, .7 mm Pitch | Open |  | Timberline |  | 3 | ea | $0.02 | $0.05
Hardware |  | HD-WA0005 | M4 Washer | Open |  | Timberline |  | 3 | ea | $0.00 | $0.01
Hardware |  | HD-MS0030 | M3-.5 3.8mm Heatset Insert |  |  | Timberline |  | 2 | ea | $0.07 | $0.13
Hardware |  | HD-BT0020 | M3 x 5 Bolt, SHCS Black-Oxide | Open |  | McMaster-Carr Supply Company | 91290A110 | 2 | ea | $0.06 | $0.12
Hardware |  | HD-WA0001 | M3 Washer, Steel, Zinc Plated | Open |  | Timberline |  | 2 | ea | $0.00 | $0.00
Printed |  | PP-GP0082 | Powerbox, power supply enclosure | Aleph Objects |  | Aleph Objects |  | 1 | ea | $1.80 | $1.80
Labor+non-supplies electroinics |  |  |  |  |  | RPC |  | 1 | ea | 0.01 | $37.67 | 37.67
Power Thru Case Assembly, TAZ |  | EL-HR0021 |  |  |  |  |  | 1 |  |  | $12.64 |  | 4
Electronic |  |  | 6 pin screw terminal connector |  |  | Ultimachine |  | 1 | ea | $0.00
Electronic |  |  | RECEPT ASSEM W/THREADED FASTENER |  |  | Digikey | A113036-ND | 1 | ea | $6.36
Electronic |  |  | CONTACT PIN 14-18AWG CRIMP TIN |  |  | Digikey | 1-66361-6-ND | 4 | ea | $0.29
Electronic |  |  | Wire, Red, 16AWG Stranded |  |  | Mcmaster-Carr Supply Company | 7587K962 | 360 | mm | $0.00
Electronic |  |  | Wire, Yellow, 16AWG Stranded |  |  | McMaster-Carr Supply Company | 7587K963 | 360 | mm | $0.00
Electronic |  |  | Conn, Crimp, .250, 14-16AWG | TE Connectivity | 3-350820-2 | Digikey | A27824-ND | 2 | ea | $0.19
Electronic |  |  | Wire, Red, 16AWG Stranded |  |  | Mcmaster-Carr Supply Company | 7587K962 | 180 | mm | $0.00
Electronic |  |  | Conn, Crimp, .250, 14-16AWG | TE Connectivity | 3-350820-2 | Digikey | A27824-ND | 1 | ea | $0.19
Electronic |  |  | Wire, Red, 16AWG Stranded, stripped on both ends |  |  | Mcmaster-Carr Supply Company | 7587K962 | 50 | mm | $0.00
Electronic |  |  | Wire, Yellow, 16AWG Stranded, stripped on both ends |  |  | McMaster-Carr Supply Company | 7587K963 | 50 | mm | $0.00
Electronic |  |  | Stock wires from RAMBo Kit |  |  | Ultimachine |  | 1 | ea | $0.00
Labor+non-supplies electroinics |  |  |  |  |  | RPC |  | 1 | ea | 0.01 | $12.64
Y switch extension |  | EL-HR0009 |  |  |  |  |  | 1 |  |  | $4.01 | 4.01 | 4
Electronic |  |  | Stock wires from RAMBo Kit |  |  | Ultimachine |  | 1 | ea | $0.00
Electronic |  |  | Connector Crimp, Female | Molex Inc. | 16-02-0102 | Digikey | WM2510-ND | 2 | ea | $0.05
Electronic |  |  | Connector Pins, Male | Molex | 16-02-0108 | Digikey | WM2565-ND | 2 | ea | $0.11
Electronic |  |  | CONN HOUSING 2POS .100 W/LATCH |  |  | Digikey | WM2900-ND | 1 | ea | $0.32
Electronic |  |  | CONN HOUSING MALE 2POS .100 |  |  | Digikey | WM2533-ND | 1 | ea | $0.51
Labor+non-supplies electroinics |  |  |  |  |  | RPC |  | 1 | ea | 0.01 | $4.01 | 4.01
Z switch extension |  | EL-HR0008 |  |  |  |  |  | 1 |  |  | $2.49 |  | 4
Electronic |  |  | Stock wires from RAMBo Kit |  |  | Ultimachine |  | 1 | ea | $0.00
Electronic |  |  | Connector Crimp, Female | Molex Inc. | 16-02-0102 | Digikey | WM2510-ND | 2 | ea | $0.05
Labor+non-supplies electroinics |  |  |  |  |  | RPC |  | 1 | ea | 0.01 | $2.49 | 2.49
Heat Bed Extensions |  | EL-HR0006 |  |  |  |  |  | 1 |  |  | 5.82 |  | 4
Electronic |  |  | Wire - Single Conductor 16AWG Purple, 100' |  |  | Mcmaster-Carr Supply Company | 7587K079 | 1240 | mm | $0.00
Electronic |  |  | Stranded Single-Conductor Wire, UL 1007/1569, 24 AWG, 300 VAC, Yellow, 100' Length |  |  | Mcmaster-Carr Supply Company | 7587K923 | 1240 | mm | $0.00
Electronic |  |  | Heavy Duty Power Connectors HOUSING ONLY, BLACK POWERPOLE 15/45 |  |  | Mouser | 879-1327G6-BK | 2 | ea | $0.18
Electronic |  |  | Heavy Duty Power Connectors POWERPOLE 15A CONT |  |  | Mouser | 879-1332-BK | 2 | ea | $0.12
Electronic |  |  | Connector Crimp, Female | Molex Inc. | 16-02-0102 | Digikey | WM2510-ND | 4 | ea | $0.05
Electronic |  |  | CONN HOUSING 2POS .100 W/LATCH |  |  | Digikey | WM2900-ND | 2 | ea | $0.32
Labor+non-supplies electroinics |  |  |  |  |  | RPC |  | 1 | ea | 0.01 | $5.82 | 5.82
LCD Wire Harness |  | EL-HR0005 |  |  |  |  |  | 1 |  |  | 27.33 |  | 4
Electronic |  |  | Flat Cables .050" 10C SHIELDED BLACK 28AWG STRANDED | 3M | 3517/10-100SF | Mouser | 517-3517/10 | 1260 | mm
Electronic |  |  | CONN HOUSING 8POS .100 DUAL |  |  | Digikey | WM2521-ND | 1 | ea | $1.09
Electronic |  |  | CONN HOUSING 20POS .100 DUAL |  |  | Digikey | WM2527-ND | 1 | ea | $1.39
Electronic |  |  | Connector Crimp, Female | Molex Inc. | 16-02-0102 | Digikey | WM2510-ND | 18 | ea | $0.05
Electronic |  |  | CONN SOCKET IDC 10POS DUAL 30AU |  |  | Digikey | 609-1739-ND | 2 | ea | 0.804
Labor+non-supplies electroinics |  |  |  |  |  | RPC |  | 1 | ea | 27.33 | $27.33 | 27.33
 |  |  |  |  |  |  |  |  |  |  |  | 128.53
Tool Kit, TAZ |  | TL-MS0019 |  |  |  |  |  |  |  |  | $42.66
Tools |  | TL-MS0001 | Tool Kit Bag w/ LulzBot logo |  | TL-MS0001 | Specialty incentives Inc. |  | 1 | ea | $15.99 | $15.99 |  | 8 | Jeff | 700
Tools |  | TL-MS0020 | Stainless Steel/Straight Instrument Cleaner Brush |  | TL-HD0006 | Gordon Brush | 906501 | 1 | ea | $9.15 | $8.71 |  |  | Jeff |  | http://www.gordonbrush.com/stainless-steel/straight-instrument-cleaner-brush-p-1294-l-en.html
Tools |  | TL-HD0046 | Pro Dental Pick, 5 3/4 in |  | TL-HD0007 | Precision Products | J1031S | 1 | ea | $1.05 | $1.05 |  |  | Jeff
Tools |  | TL-HD0008 | Stainless Steel Pocket Rule Semiflexible, Metric Grads, 150 mm Length |  | TL-HD0008 | McMaster-Carr Supply Company | 6813a62 | 1 | ea | $2.62 | $2.62 |  | 1 | Jeff
Tools |  | TL-HD0009 | 7 1/2" Nylon Handle Clam Knife |  | TL-HD0009 | WEBstaurant Store | 35340592 | 1 | ea | $2.03 | $2.03 |  |  | Jeff |  |  | Food Machinery of America Inc. Omcan Food Machinery
Tools |  | TL-HD0048 | Elmer's X-Acto No. 1 Precision Knife – Aluminum |  | TL-HD0010 | Business Supply | EPIX3201 | 1 | ea | $2.14 | $2.14 |  |  | Jeff | http://www.business-supply.com/p-8487-elmers-x-acto-no-1-precision-knife-aluminum.aspx?id={adwords_producttargetid}
Tools |  | TL-HD0049 | 6'' Deluxe Bent Stainless Steel Tweezer with Serrated Teeth |  | TL-HD0011 | Roeder Industries | TWE6 | 1 | ea | $2.25 | $2.25 |  |  | Jeff | http://roederindustries.com/shopexd.asp?id=1153
Tools |  | TL-HD0050 | 6" Professional Long Nose Pliers |  | TL-HD0012 | Creative Home & Gardening | CJ25328493 | 1 | ea | $5.49 | $5.49 |  |  | Jeff | http://creativehomeandgardening.com/catalog/chg_catalog.mvc?cat+select+HTA+004440+CJ25328493
Tools |  | TL-HD0047 | Tekton 13-pc. Long Arm Ball Hex Key Wrench Set (Metric) |  | TL-HD0013 | Sears | SPM2092250003 | 1 | ea | $9.10 | $9.10 |  |  | Jeff | http://www.sears.com/tekton-13-pc-long-arm-ball-hex-key/p-SPM2092250003?prdNo=10&blockNo=160&blockType=G160
Tools |  | TL-MS0002 | HDPE, 8 oz. Natural Large Round Wide-Mouth Jars |  | TL-MS0002 | Uline | S-18070 | 1 | ea | $0.58 | $0.58 |  | 1 | Jeff
Tools |  | TL-HD0014 | Standard-Head Open-End Wrench Black Finish, 13mm Sz, 4-7/8" Length, 15 Deg Angle |  | TL-HD0014 | Mcmaster-Carr Supply Company | 5488A19 | 1 | ea | $7.66 | $7.66 |  | 1 | Jeff | http://www.lowes.com/pd_337643-25428-85661_0__?productId=3387150&Ntt=13mm+wrench&Ns=p_product_price|0 | Lowes only has 65, cant back order
Tools |  | DC-LB0005 | 2 x 2" D.O.T. Labels - "Right to Know" |  | TL-MS0003 | Uline | S-2845 | 1 | ea | $0.03 | $0.03 |  | 1 | Jeff
Labor |  |  |  |  |  | On Time Mailing |  | 1 | ea | $1.00 | $1.00
