alephobjects/taz-toolhead-kanyu/flexystruder/production_docs/200-flexystruder_order_6-03-14.ods

Order |  | QTY = | 200
Category | Status | AO Part # | Description | Manufacturer | Manufacturer PN | Distributor | Distributor SKU | Qty Per | UOM | Qty to order |  | Price Per Unit | Price Total | PO | PO Date | Est. Date | Comment | Notes
Timberline / McMaster
Hardware |  | HD-NT0004 | M3 Nut, Zinc Plated |  |  | Timberline |  | 1 | ea | 203 | ea | $0.01 | $0.01 | PO03803 | 07/10/14 | 07/17/14 | small herringbone gear, extruder idler | McMaster-Carr Supply Company | 90591A121
Hardware | 1 | HD-BT0012 | M3 Set Screw (Grub Screw) |  |  | Timberline |  | 1 | ea | 205 | ea | $0.02 | $0.02 | PO03803 | 07/10/14 | 07/17/14 | extruder, rods and switches | McMaster-Carr Supply Company | 91390A100
Hardware | 2 | HD-MS0030 | M3-.5 3.8mm Heatset Insert |  |  | Timberline |  | 4 | ea | 820 | ea | $0.07 | $0.27 | PO03803 | 07/10/14 | 07/17/14 |  | McMasterCarr | 94180A331
Hardware | 3 | HD-BT0039 | M3 x 10 Bolt, SHCS Black-Oxide |  |  | Timberline |  | 3 | ea | 610 | ea | $0.06 | $0.18 | PO03803 | 07/10/14 | 08/21/14 | RAMBo board | McMaster-Carr Supply Company | 91290A110
Hardware | 4 | HD-WA0001 | M3 Washer, Steel, Zinc Plated |  |  | Timberline |  | 3 | ea | 610 | ea | $0.00 | $0.00 | PO03803 | 07/10/14 | 07/17/14 |  | McMaster-Carr Supply Company | 91166A210
Hardware | 5 | HD-BT0010 | M4 x 20 Bolt, SHCS Black-Oxide |  |  | Timberline |  | 2 | ea | 405 | ea | $0.04 | $0.07 | PO03803 | 07/10/14 | 07/17/14 | Extruder/Buda | McMaster-Carr Supply Company | 91290A168
Hardware | 6 | HD-WA0005 | M4 Washer |  |  | Timberline |  | 2 | ea | 410 | ea | $0.00 | $0.01 | PO03803 | 07/10/14 | 07/17/14 | Extruder/Buda | McMaster-Carr Supply Company | 91166A230
Hardware | 7 | HD-NT0011 | M4 Nut,Zinc-Plated Steel |  |  | Timberline |  | 2 | ea | 406 | ea | $0.01 | $0.02 | PO03803 | 07/10/14 | 07/17/14 | extruder/buda | McMaster-Carr Supply Company | 90591A141
Hardware | 8 | HD-NT0002 | M8 Nyloc Nut, Zinc Plated |  |  | Timberline |  | 1 | ea | 203 | ea | $0.05 | $0.05 | PO03803 | 07/10/14 | 07/17/14 | bearings, extruder | McMaster-Carr Supply Company | 90576A117
Hardware |  | HD-WA0008 | M8 shim washer - .5mm |  |  | Timberline |  | 1 | ea | 200 | ea | $0.01 | $0.01 | PO03803 | 07/10/14 | 07/17/14 | extruder, spooler,bearings | McMaster-Carr Supply Company | 91166A270
Hardware |  | HD-WA0009 | M8 shim washer – 1.0mm |  |  | Timberline |  | 1 | ea | 200 | ea | $0.01 | $0.01 | PO03803 | 07/10/14 | 07/17/14 | extruder, spooler,bearings | McMaster-Carr Supply Company | 91166A270
Hardware | 9 | HD-WA0006 | M8 Washer, Steel, Zinc Plated |  |  | Timberline |  | 3 | ea | 605 | ea | $0.01 | $0.04 | PO03803 | 07/10/14 | 07/17/14 | extruder, spooler,bearings | McMaster-Carr Supply Company | 91166A270
Hardware | 10 | HD-MS0060 | M5-.8 11mm Heatset Insert |  |  | Timberline |  | 1 | ea | 205 | ea | $0.22 | $0.22 | PO03803 | 07/10/14 | 07/17/14 |  | McMasterCarr | 94180A363
Hardware |  | HD-BT0049 | M5 x 14 Bolt, SHCS Black_Oxide |  |  | Timberline |  | 1 | ea | 200 | ea | $0.03 | $0.03 | PO03803 | 07/10/14 | 07/17/14 |  | Mcmaster-Carr Supply Company | 91290A230
Hardware |  | HD-MS0055 | Thumb Screw Knob for M5 SHCS, Black |  |  | Timberline |  | 1 | ea | 200 | ea | $0.11 | $0.11 | PO03803 | 07/10/14 | 07/17/14 |  | McMaster-Carr Supply Company | 91175A063
Mcmaster
Hardware |  | HD-TB0006 | .25”ODx.125”ID PTFE tube (~2.5”) |  |  | McMaster-Carr Supply Company | 8547K23 | 100 | mm | 20000 | mm |  |  |  |  |  |  | This mcmaster PTFE is inconsistent and a recent batch was unusable. We should try the line below
Hardware |  | HD-TB0006 | .25”ODx.125”ID PTFE tube (~4”) - 50' roll |  |  | Zoro Tools | G3251001 | 100 | mm | 20000 | mm | $0.85 | $85.00 | PO03799 | 07/10/14 | 07/17/14 | only comes in 50' rolls ($105) | This Zoro tools PTFE should be much more consistent – need to test before using in production – only comes in 50' rolls (~150flexy's)
Electronic |  | part of EL-HR0016-2 | EMI/RFI-Shield Heat-Shrink Tubing 3/16" ID Before, 3/32" ID After, 48" L, Black, cut to 50mm |  |  | Mcmaster-Carr Supply Company | 7937K31 | 80 | mm | 16000 | mm | $0.01 | $1.11 | PO03804 | 07/10/14 | 07/17/14
VXB
Mechanical | 11 | HD-MS0204 | 608ZZ sealed bearing |  |  | vxb.com | kit708 | 2 | ea | 405 | ea | $0.54 | $1.08 | PO03805 | 07/10/14 | 07/17/14
In-House
Printed |  |  | Flexystruder Body V1.1 | Aleph Objects |  | Aleph Objects |  | 1 | ea | 200 | ea |  |  |  |  |  | Lulz Green?
Printed |  | PP-GP0061 | herringbone_large_gear | Aleph Objects |  | Aleph Objects |  | 1 | ea | 200 | ea | $0.56 | $0.56 |  |  |  | extruder
Printed |  | PP-GP0062 | herringbone_small_gear | Aleph Objects |  | Aleph Objects |  | 1 | ea | 200 | ea | $0.08 | $0.08 |  |  |  | extruder
Printed |  | PP-GP0096 | Extruder mount, TAZ | Aleph Objects |  | Aleph Objects |  | 1 | ea | 200 | ea | $1.43 | $1.43 |  |  |  | Lulz Green
Printed |  | PP-GP0060 | Wade Reloaded Bearing Washer | Aleph Objects |  | Aleph Objects |  | 1 | ea | 200 | ea | $0.00 | $0.00 |  |  |  | extruder
Mechanical | 12 | HE-SH0027 | Assy, Budaschnozzle 2.0c with 0.5 nozzle | Aleph Objects |  | Aleph Objects |  | 1 | ea | 200 | ea | $52.00 | $52.00
MBK
Hardware | 13 | HD-BT0108 | Hobbed Bolt, M8 x 50mm Hex head, 26mm offset, Stainless Steel |  |  | MBK |  | 1 | ea | 200 | ea | $4.00 | $4.00 | PO03812 | 07/11/14
Digikey
Electronic | 14 | part of EL-HR0016-2 | Connector Pins, Male | Molex | 16-02-0108 | Digikey | WM2565-ND | 4 | ea | 800 | ea | $0.11 | $0.44 | PO03806 | 07/10/14 | 07/17/14
Electronic | 15 | part of EL-HR0016-2 | Connector, 4 pin Male housing with latch | Molex | 701070003 | Digikey | WM2535-ND | 1 | ea | 200 | ea | $0.51 | $0.51 | PO03806 | 07/10/14 | 07/17/14
Soyo
Electronic |  | EL-HR0016-2 | NEMA 17 Stepper Motors, wires cut to 60mm |  |  | Soyo | SY42STH47-1504A | 1 | ea | 200 | ea | $7.78 | $7.78 | PO03814 |  |  | Do we have these on hand? |  | No, putting a year end motor order together
