alephobjects/taz-toolhead-kanyu/flexystruder/production_docs/Flexystruder-V1.1-BOM.ods

Sheet: FlexyBOM
Flexystruder 1.1 BOM
Category | Status | AO Part # | Description | Manufacturer | Manufacturer PN | Distributor | Distributor SKU | Qty Per | UOM | Price Per Unit | Price Total | Comment | Lead Time (wks) | Responsible | To Order | Notes
Printed |  |  | Flexystruder Body V1.1 | Aleph Objects |  | Aleph Objects |  | 1 | ea |  |  | Lulz Green
Printed |  | PP-GP0061 | herringbone_large_gear | Aleph Objects |  | Aleph Objects |  | 1 | ea | $0.56 | $0.56 | extruder
Printed |  | PP-GP0062 | herringbone_small_gear | Aleph Objects |  | Aleph Objects |  | 1 | ea | $0.08 | $0.08 | extruder
Printed |  | PP-GP0096 | Extruder mount, TAZ | Aleph Objects |  | Aleph Objects |  | 1 | ea | $1.43 | $1.43 | Lulz Green
Printed |  | PP-GP0060 | Wade Reloaded Bearing Washer | Aleph Objects |  | Aleph Objects |  | 1 | ea | $0.00 | $0.00 | extruder
Hardware |  | HD-NT0004 | M3 Nut, Zinc Plated |  |  | Timberline |  | 1 | ea | $0.01 | $0.01 | small herringbone gear, extruder idler |  |  |  | McMaster-Carr Supply Company | 90591A121
Hardware |  | HD-BT0012 | M3 Set Screw (Grub Screw) |  |  | Timberline |  | 1 | ea | $0.02 | $0.02 |  |  |  |  | McMaster-Carr Supply Company | 91390A100
Hardware |  | HD-MS0030 | M3-.5 3.8mm Heatset Insert |  |  | Timberline |  | 4 | ea | $0.07 | $0.27 |  |  |  |  | McMasterCarr | 94180A331
Hardware |  | HD-BT0039 | M3 x 12 Bolt, SHCS Black-Oxide |  |  | Timberline |  | 3 | ea | $0.06 | $0.18 |  |  |  |  | McMaster-Carr Supply Company | 91290A110
Hardware |  | HD-WA0001 | M3 Washer, Steel, Zinc Plated |  |  | Timberline |  | 3 | ea | $0.00 | $0.00 |  |  |  |  | McMaster-Carr Supply Company | 91166A210
Hardware |  | HD-BT0010 | M4 x 20 Bolt, SHCS Black-Oxide |  |  | Timberline |  | 2 | ea | $0.04 | $0.07 | Extruder/Buda |  |  |  | McMaster-Carr Supply Company | 91290A168
Hardware |  | HD-WA0005 | M4 Washer |  |  | Timberline |  | 2 | ea | $0.00 | $0.01 | Extruder/Buda |  |  |  | McMaster-Carr Supply Company | 91166A230
Hardware |  | HD-NT0011 | M4 Nut,Zinc-Plated Steel |  |  | Timberline |  | 2 | ea | $0.01 | $0.02 | extruder/buda |  |  |  | McMaster-Carr Supply Company | 90591A141
Hardware |  | HD-BT0108 | Short Hobbed bolt, M8 x 50 Hex Head Bolt |  |  | quattro |  | 1 | ea | $4.00 | $4.00 | extruder
Hardware |  | HD-NT0002 | M8 Nyloc Nut, Zinc Plated |  |  | Timberline |  | 1 | ea | $0.05 | $0.05 | bearings, extruder |  |  |  | McMaster-Carr Supply Company | 90576A117
Hardware |  | HD-WA0008 | M8 shim washer - .5mm |  |  | Timberline |  | 1 | ea | $0.01 | $0.01 | extruder, spooler,bearings |  |  |  | McMaster-Carr Supply Company | 91166A270
Hardware |  | HD-WA0009 | M8 shim washer – 1.0mm |  |  | Timberline |  | 1 | ea | $0.01 | $0.01 | extruder, spooler,bearings |  |  |  | McMaster-Carr Supply Company | 91166A270
Hardware |  | HD-WA0006 | M8 Washer, Steel, Zinc Plated |  |  | Timberline |  | 3 | ea | $0.01 | $0.04 | extruder, spooler,bearings |  |  |  | McMaster-Carr Supply Company | 91166A270
Mechanical |  | HD-MS0013 | 608ZZ bearing |  |  | vxb.com | 100Skate | 2 | ea | $0.21 | $0.42
Hardware |  | HD-MS0060 | M5-.8 11mm Heatset Insert |  |  | Timberline |  | 1 | ea | $0.22 | $0.22 |  |  |  |  | McMasterCarr | 94180A363
Hardware |  | HD-BT0049 | M5 x 14 Bolt, SHCS Black_Oxide |  |  | Timberline |  | 1 | ea | $0.03 | $0.03 |  |  |  |  | Mcmaster-Carr Supply Company | 91290A230
Hardware |  | HD-MS0055 | Thumb Screw Knob for M5 SHCS, Black |  |  | Timberline |  | 1 | ea | $0.11 | $0.11 |  |  |  |  | McMaster-Carr Supply Company | 91175A063
Hardware |  | HD-TB0006 | .25”ODx.125”ID PTFE tube (~4”) - 50' roll |  |  | Zoro Tools | G3251001 | 0.25 | ft | $0.70 | $0.70 | only comes in 50' rolls ($105) |  |  |  | This Zoro tools PTFE should be much more consistent – need to test before using in production – only comes in 50' rolls (~150flexy's)
Hardware |  | HD-TB0006 | .25”ODx.125”ID PTFE tube (~2.5”) |  |  | McMaster-Carr Supply Company | 8547K23 | 1 |  |  |  |  |  |  |  | This mcmaster PTFE needs to be replaced due to inconsistent quality and diameter
Mechanical |  | HE-SH0027 | Assy, Budaschnozzle 2.0c with 0.5 nozzle | Aleph Objects |  | Aleph Objects |  | 1 | ea | $52.00 | $52.00
Electronic |  | EL-HR0016-2 | NEMA 17 Stepper Motors, wires cut to 60mm |  |  | Soyo | SY42STH47-1504A | 1 | ea | $7.78 | $7.78
Electronic |  | part of EL-HR0016-2 | Connector Pins, Male | Molex | 16-02-0108 | Digikey | WM2565-ND | 4 | ea | $0.11 | $0.44
Electronic |  | part of EL-HR0016-2 | Connector, 4 pin Male housing with latch | Molex | 701070003 | Digikey | WM2535-ND | 1 | ea | $0.51 | $0.51
Electronic |  | part of EL-HR0016-2 | EMI/RFI-Shield Heat-Shrink Tubing 3/16" ID Before, 3/32" ID After, 48" L, Black, cut to 50mm |  |  | Mcmaster-Carr Supply Company | 7937K31 | 80 | mm | $0.01 | $1.11
 |  |  |  |  |  |  |  |  |  | Total Flexystruder BOM cost | $70.07

Sheet: Order
Order |  | QTY = | 100
Category | Status | AO Part # | Description | Manufacturer | Manufacturer PN | Distributor | Distributor SKU | Qty Per | UOM | Qty to order |  | Price Per Unit | Price Total | Comment | Lead Time (wks) | Responsible | To Order | Notes
Timberline / McMaster
Hardware |  | HD-NT0004 | M3 Nut, Zinc Plated |  |  | Timberline |  | 1 | ea | 103 | ea | $0.01 | $0.01 |  |  |  |  | McMaster-Carr Supply Company | 90591A121
Hardware |  | HD-BT0012 | M3 Set Screw (Grub Screw) |  |  | Timberline |  | 1 | ea | 105 | ea | $0.02 | $0.02 |  |  |  |  | McMaster-Carr Supply Company | 91390A100
Hardware |  | HD-MS0030 | M3-.5 3.8mm Heatset Insert |  |  | Timberline |  | 4 | ea | 420 | ea | $0.07 | $0.27 |  |  |  |  | McMasterCarr | 94180A331
Hardware |  | HD-BT0005 | M3 x 10 Bolt, SHCS Black-Oxide |  |  | Timberline |  | 3 | ea | 310 | ea | $0.06 | $0.18 |  |  |  |  | McMaster-Carr Supply Company | 91290A115
Hardware |  | HD-WA0001 | M3 Washer, Steel, Zinc Plated |  |  | Timberline |  | 3 | ea | 310 | ea | $0.00 | $0.00 |  |  |  |  | McMaster-Carr Supply Company | 91166A210
Hardware |  | HD-BT0010 | M4 x 20 Bolt, SHCS Black-Oxide |  |  | Timberline |  | 2 | ea | 205 | ea | $0.04 | $0.07 |  |  |  |  | McMaster-Carr Supply Company | 91290A168
Hardware |  | HD-WA0005 | M4 Washer |  |  | Timberline |  | 2 | ea | 210 | ea | $0.00 | $0.01 |  |  |  |  | McMaster-Carr Supply Company | 91166A230
Hardware |  | HD-NT0011 | M4 Nut,Zinc-Plated Steel |  |  | Timberline |  | 2 | ea | 206 | ea | $0.01 | $0.02 |  |  |  |  | McMaster-Carr Supply Company | 90591A141
Hardware |  | HD-NT0002 | M8 Nyloc Nut, Zinc Plated |  |  | Timberline |  | 1 | ea | 103 | ea | $0.05 | $0.05 |  |  |  |  | McMaster-Carr Supply Company | 90576A117
Hardware |  | HD-WA0008 | M8 shim washer - .5mm |  |  | Timberline |  | 1 | ea | 100 | ea | $0.01 | $0.01 |  |  |  |  | McMaster-Carr Supply Company | 91166A270
Hardware |  | HD-WA0009 | M8 shim washer – 1.0mm |  |  | Timberline |  | 1 | ea | 100 | ea | $0.01 | $0.01 |  |  |  |  | McMaster-Carr Supply Company | 91166A270
Hardware |  | HD-WA0006 | M8 Washer, Steel, Zinc Plated |  |  | Timberline |  | 3 | ea | 305 | ea | $0.01 | $0.04 |  |  |  |  | McMaster-Carr Supply Company | 91166A270
Hardware |  | HD-MS0060 | M5-.8 11mm Heatset Insert |  |  | Timberline |  | 1 | ea | 105 | ea | $0.22 | $0.22 |  |  |  |  | McMasterCarr | 94180A363
Hardware |  | HD-BT0049 | M5 x 14 Bolt, SHCS Black_Oxide |  |  | Timberline |  | 1 | ea | 100 | ea | $0.03 | $0.03 |  |  |  |  | Mcmaster-Carr Supply Company | 91290A230
Hardware |  | HD-MS0055 | Thumb Screw Knob for M5 SHCS, Black |  |  | Timberline |  | 1 | ea | 100 | ea | $0.11 | $0.11 |  |  |  |  | McMaster-Carr Supply Company | 91175A063
Mcmaster
Hardware |  | HD-TB0006 | .25”ODx.125”ID PTFE tube (~4”) |  |  | McMaster-Carr Supply Company | 8547K23 | 0.25 | ft | 25 | ft |  |  |  |  |  |  | This mcmaster tubing sucks – replacing with line below
Hardware |  | HD-TB0006 | .25”ODx.125”ID PTFE tube (~4”) - 50' roll |  |  | Zoro Tools | G3251001 | 0.25 | ft | 25 | ft | $0.70 | $70.00 | only comes in 50' rolls ($105) |  |  |  | This Zoro tools PTFE should be much more consistent – need to test before using in production – only comes in 50' rolls (~150flexy's)
Electronic |  | TL-CS0083 | EMI/RFI-Shield Heat-Shrink Tubing 3/16" ID Before, 3/32" ID After, 48" L, Black, cut to 50mm |  |  | Mcmaster-Carr Supply Company | 7937K31 | 45 | mm | 4500 | mm | $0.01 | $1.11
Electronic |  | TL-CS0129 | Interference-Shielding Heat-Shrink Tubing, 3/8" ID Before, 3/16" ID After, 48" Long, Black |  |  | Mcmaster-Carr Supply Company | 7937K33 | 25 | mm
VXB
Mechanical |  | HD-MS0204 | 100 Sealed Skateboard/inline/Rollerblade Skate Bearing Ball Bearings |  |  | vxb.com | kit708 | 2 | ea | 205 | ea | $0.53 | $1.06
In-House
Printed |  | PP-GP0166 | Flexystruder Body V1.1b | Aleph Objects |  | Aleph Objects |  | 1 | ea | 100 | ea |  |  | Lulz Green?
Printed |  | PP-GP0061 | herringbone_large_gear | Aleph Objects |  | Aleph Objects |  | 1 | ea | 100 | ea | $0.56 | $0.56 | extruder
Printed |  | PP-GP0062 | herringbone_small_gear | Aleph Objects |  | Aleph Objects |  | 1 | ea | 100 | ea | $0.08 | $0.08 | extruder
Printed |  | PP-GP0158 | Extruder Mount, TAZ, Lulz Green | Aleph Objects |  | Aleph Objects |  | 1 | ea | 100 | ea | $1.43 | $1.43 | Lulz Green
Printed |  | PP-GP0060 | Wade Reloaded Bearing Washer | Aleph Objects |  | Aleph Objects |  | 1 | ea | 100 | ea | $0.00 | $0.00 | extruder
Mechanical |  | HE-SH0027 | Assy, Budaschnozzle 2.0c with 0.5 nozzle | Aleph Objects |  | Aleph Objects |  | 1 | ea | 100 | ea | $52.00 | $52.00
MBK
Hardware |  | HD-BT0108 | Hobbed Bolt, M8 x 50mm Hex head, 26mm offset, Stainless Steel |  |  | MBK |  | 1 | ea | 100 | ea | $4.00 | $4.00 | extruder
Digikey
Electronic |  | EL-MS0205 | CONN TERM MALE 22-24AWG TIN | Molex |  | Digikey | WM2517TR-ND | 4 | ea | 400 | ea | $0.11 | $0.44
Electronic |  | EL-MS0061 | CONN HOUSING MALE 4POS .100 | Molex |  | Digikey | WM2535-ND | 1 | ea | 100 | ea | $0.51 | $0.51
Changzhou FTX Motors Co., Ltd.
Electronic |  | EL-MT0001 | NEMA 17 Stepper Motors, wires cut to 60mm |  |  | Changzhou FTX Motors Co., Ltd. | SY42STH47-1504A | 1 | ea | 100 | ea | $7.78 | $7.78
