alephobjects/taz-toolhead-kanyu/first_print/lulzbot_taz_flexystruder_keychain.stl

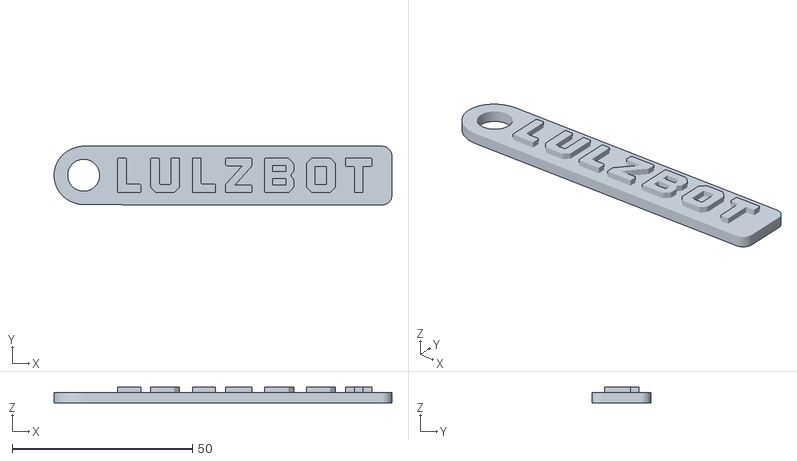
[picture p31: CAD file, 2016-08-12]
first_print/lulzbot_taz_flexystruder_keychain.stl
93.7 x 16.3 x 4.40
