alephobjects/taz-toolhead-kanyu/flexystruder/flexystruder-1.0/freecad source/flexystruder-V1.1b.stl

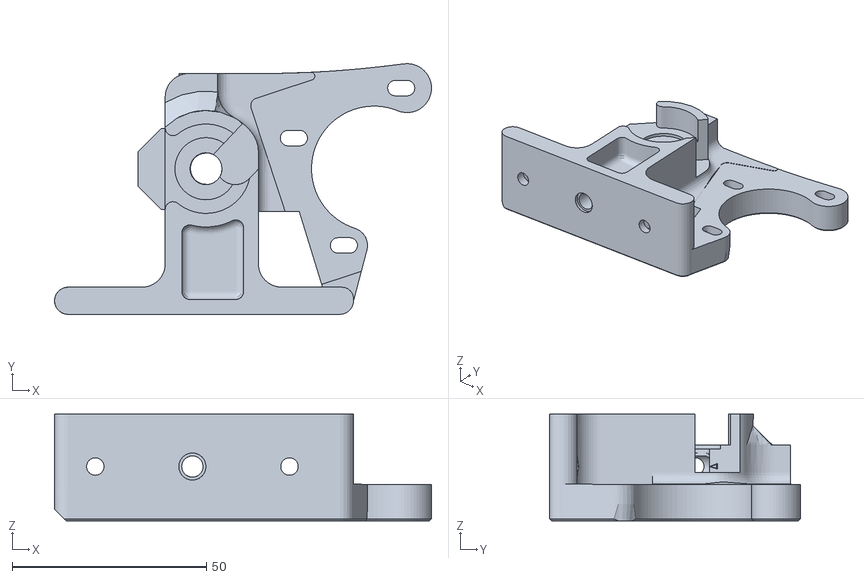
[picture p32: CAD file, 2016-08-12]
flexystruder/flexystruder-1.0/freecad source/flexystruder-V1.1b.stl
97.1 x 64.5 x 27.5
