alephobjects/taz-toolhead-kanyu/flexystruder/Novelties/Sheet.stl

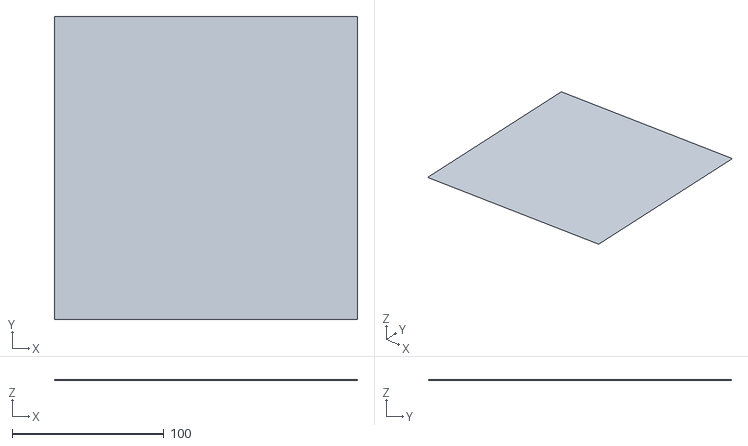
[picture p33: CAD file, 2016-08-12]
flexystruder/Novelties/Sheet.stl
200.0 x 200.0 x 0.4
