alephobjects/taz-toolhead-kanyu/production_parts/printed_parts/flexystruder_body_v2.0_for_hexagon/flexystruder_body_hex_v2.0b.stl

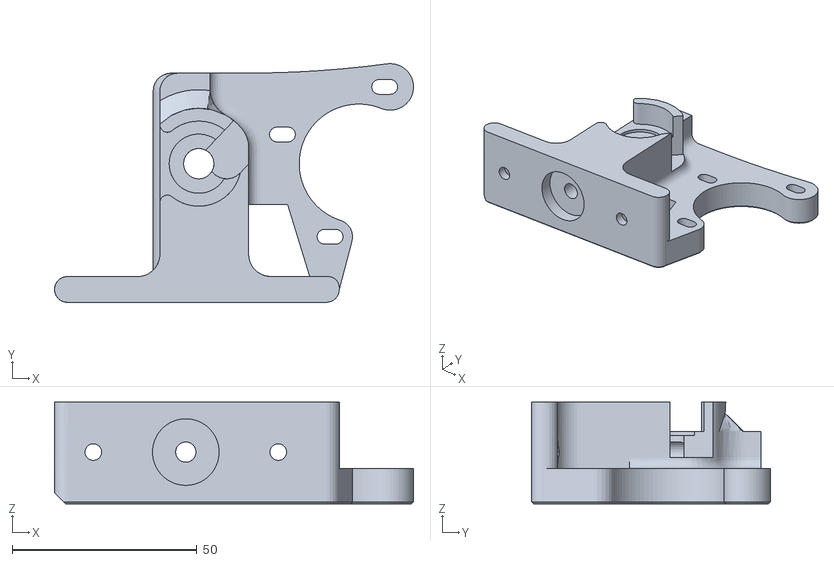
[picture p34: CAD file, 2016-08-12]
production_parts/printed_parts/flexystruder_body_v2.0_for_hexagon/flexystruder_body_hex_v2.0b.stl
97.1 x 64.5 x 27.5
