alephobjects/taz-toolhead-kanyu/production_parts/test_parts/Flexystruder_0.7.fcstd

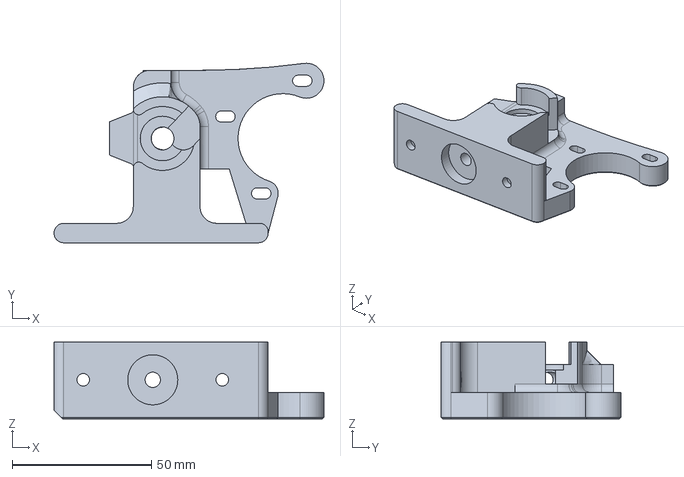
[picture p35: CAD file, 2016-08-12]
production_parts/test_parts/Flexystruder_0.7.fcstd
97.1 x 64.5 x 27.5 mm
