alephobjects/taz-toolhead-kanyu/flexystruder/flexystruder-1.0/freecad source/dualflxytest0.1.stl

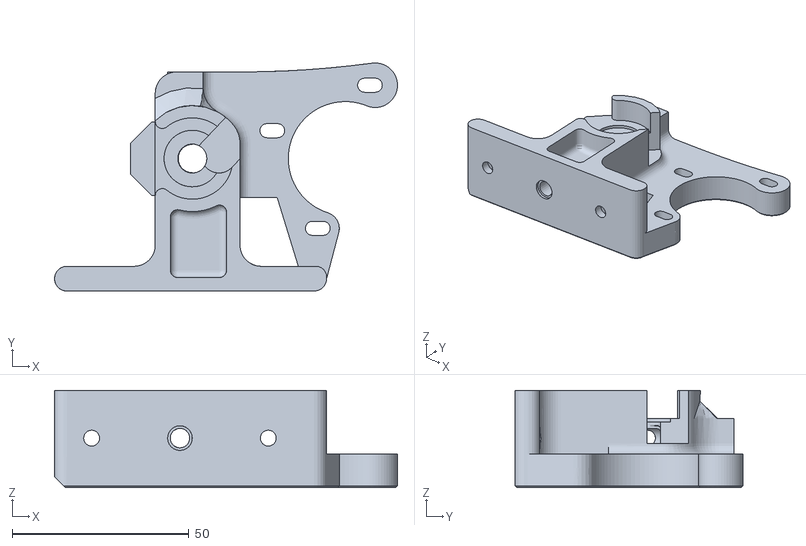
[picture p36: CAD file, 2016-08-12]
flexystruder/flexystruder-1.0/freecad source/dualflxytest0.1.stl
97.1 x 64.5 x 27.5
