alephobjects/taz-toolhead-kanyu/flexystruder/Novelties/resistance_band.fcstd

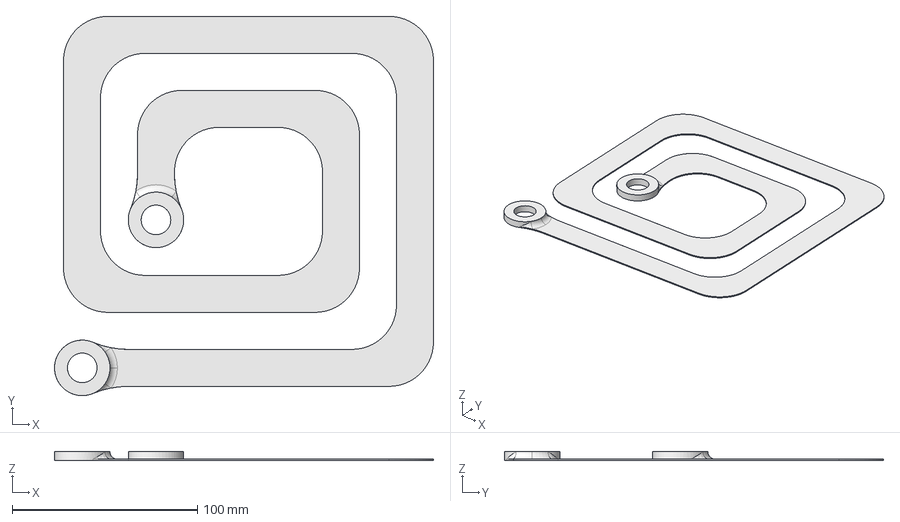
[picture p37: CAD file, 2016-08-12]
flexystruder/Novelties/resistance_band.fcstd
204.9 x 205.0 x 5.00 mm
