alephobjects/taz-toolhead-kanyu/jigs/harness_holder_bottom_v1.0.fcstd

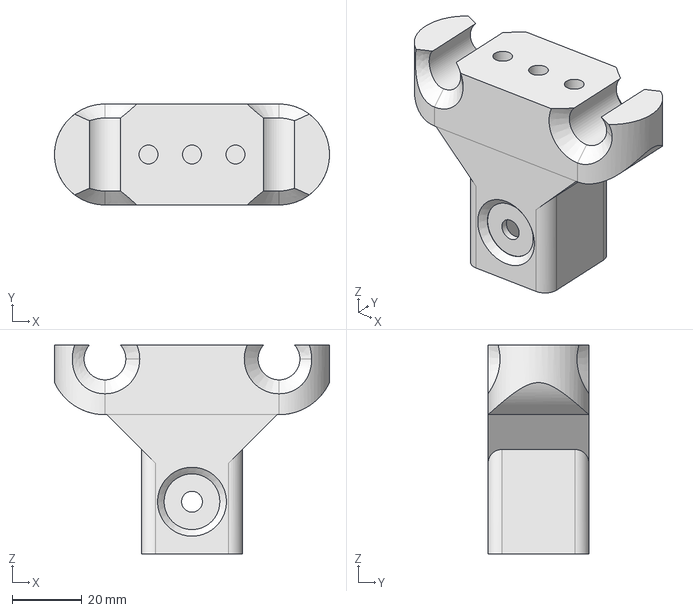
[picture p38: CAD file, 2016-08-12]
jigs/harness_holder_bottom_v1.0.fcstd
79.0 x 29.0 x 60.0 mm
