alephobjects/taz-toolhead-kanyu/production_parts/test_parts/extended_hex_nozzle_0.15_drawing.fcstd

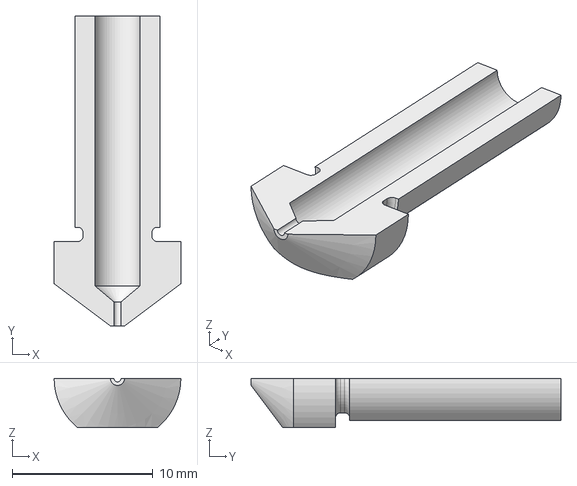
[picture p39: CAD file, 2016-08-12]
production_parts/test_parts/extended_hex_nozzle_0.15_drawing.fcstd
9.00 x 22.0 x 3.50 mm
