alephobjects/taz-toolhead-kanyu/flexystruder/Novelties/2_layer_sheet.stl

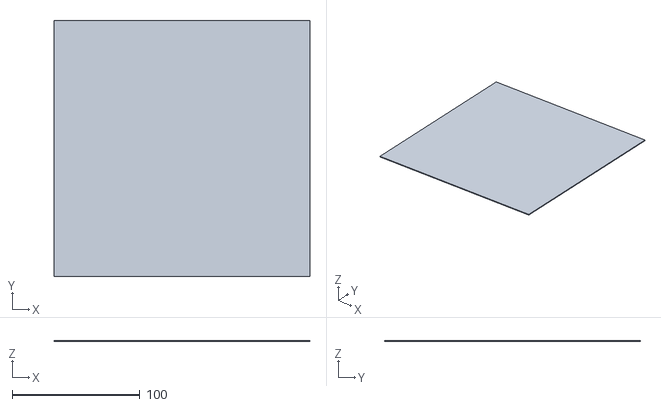
[picture p40: CAD file, 2016-08-12]
flexystruder/Novelties/2_layer_sheet.stl
200.0 x 200.0 x 0.8
