alephobjects/taz-toolhead-kanyu/jigs/200mm_wire_cut_jig.FCStd

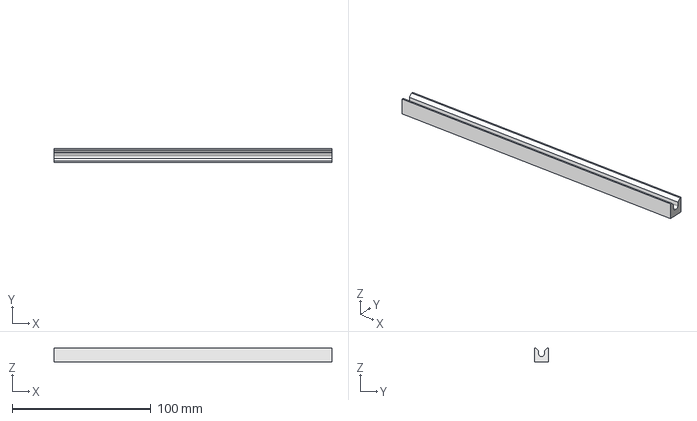
[picture p41: CAD file, 2016-08-12]
jigs/200mm_wire_cut_jig.FCStd
200.0 x 10.0 x 10.0 mm
