alephobjects/taz-toolhead-kanyu/production_parts/test_parts/extended_hex_hb_v0.15.step

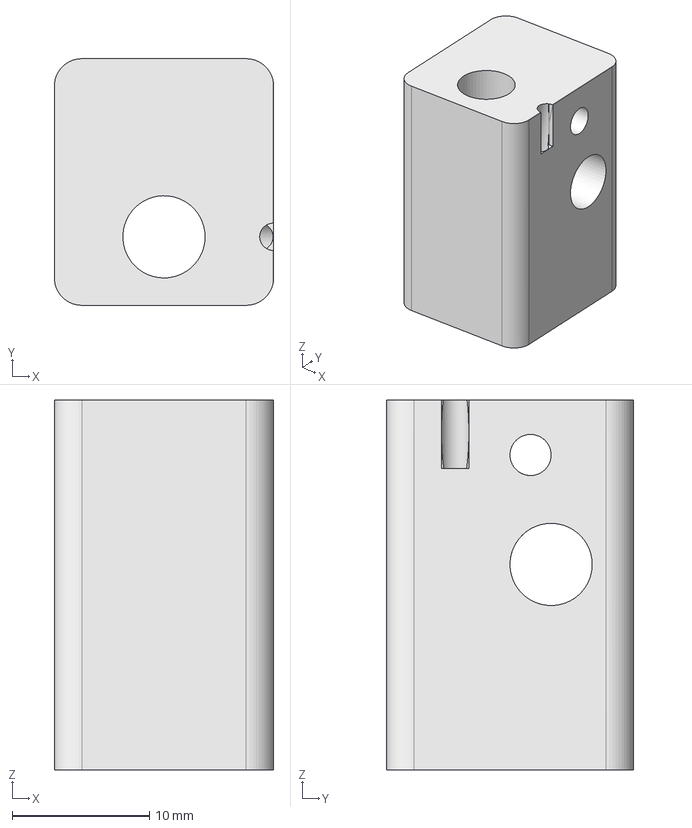
[picture p42: CAD file, 2016-08-12]
production_parts/test_parts/extended_hex_hb_v0.15.step
16.0 x 18.0 x 27.0 mm
