alephobjects/taz-toolhead-kanyu/flexystruder/Novelties/2_layer_sheet_50%.stl

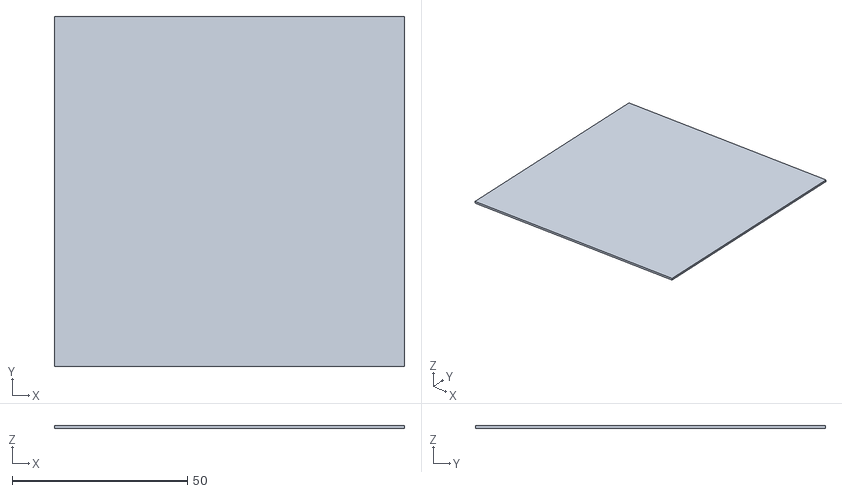
[picture p43: CAD file, 2016-08-12]
flexystruder/Novelties/2_layer_sheet_50%.stl
100.0 x 100.0 x 0.8
