alephobjects/taz-toolhead-kanyu/production_parts/test_parts/extended_hex_nozzle_0.1.fcstd

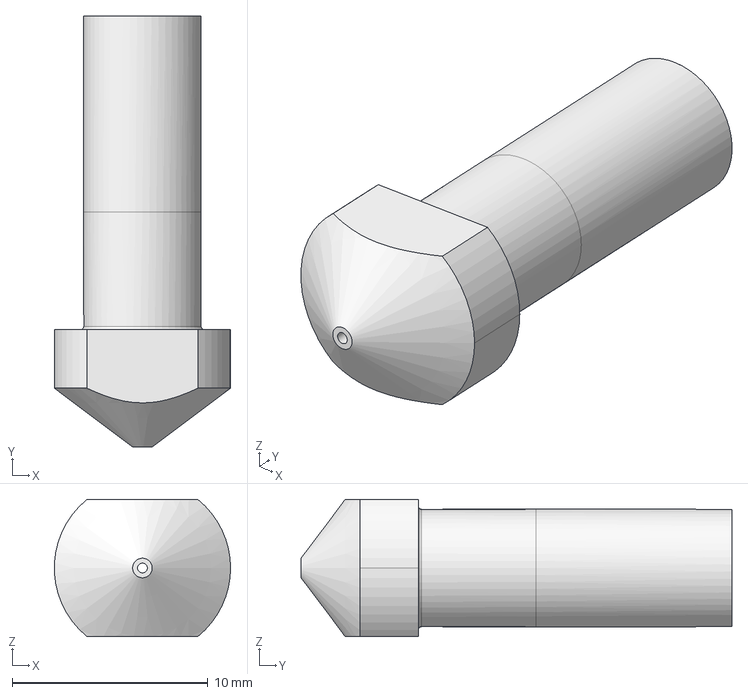
[picture p44: CAD file, 2016-08-12]
production_parts/test_parts/extended_hex_nozzle_0.1.fcstd
8.99 x 22.0 x 7.00 mm
