alephobjects/taz-toolhead-kanyu/flexystruder/Novelties/Bellows_coupling.fcstd

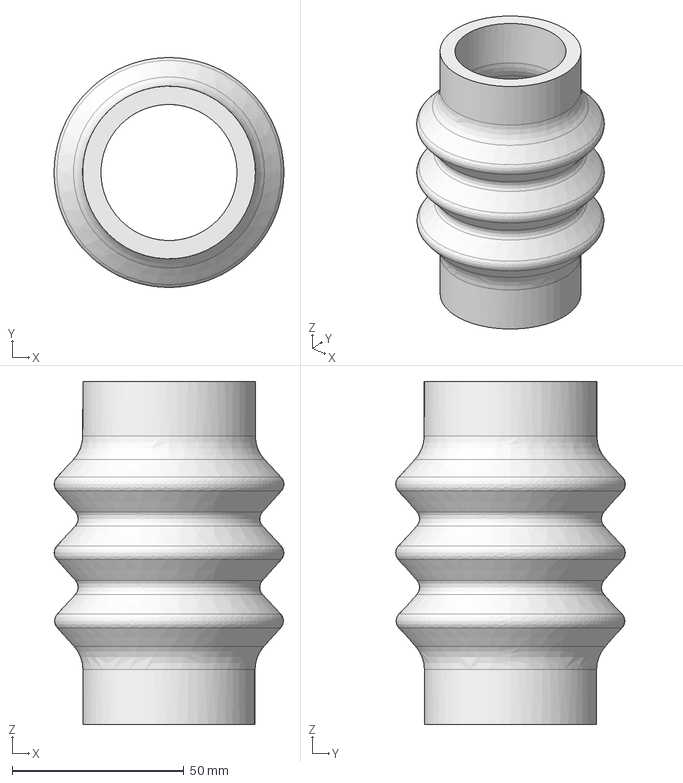
[picture p45: CAD file, 2016-08-12]
flexystruder/Novelties/Bellows_coupling.fcstd
67.0 x 67.0 x 100.0 mm
