alephobjects/taz-toolhead-kanyu/jigs/harness_holder_top_v1.0.fcstd

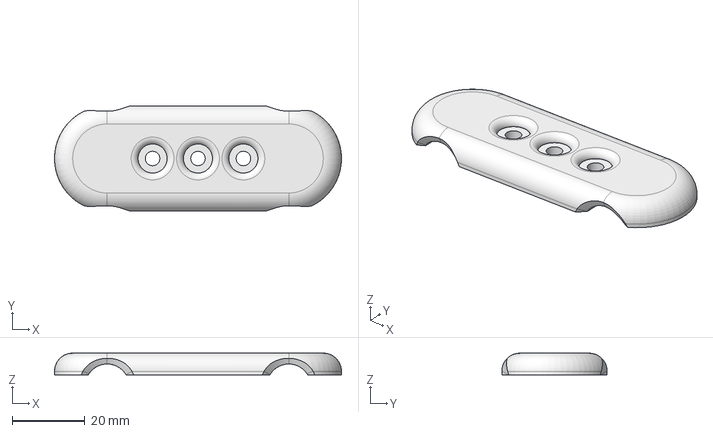
[picture p46: CAD file, 2016-08-12]
jigs/harness_holder_top_v1.0.fcstd
79.0 x 29.0 x 6.00 mm
