alephobjects/taz-toolhead-kanyu/flexystruder/Novelties/Lulzbotsheet.stl

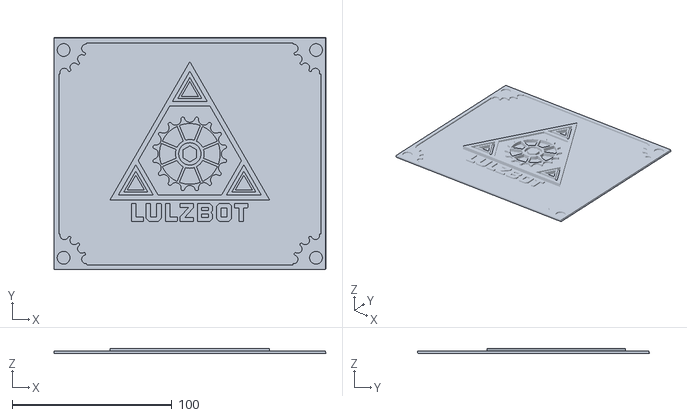
[picture p47: CAD file, 2016-08-12]
flexystruder/Novelties/Lulzbotsheet.stl
170.2 x 145.5 x 3.37
