alephobjects/taz-toolhead-kanyu/jigs/Flexystruder_holder.stl

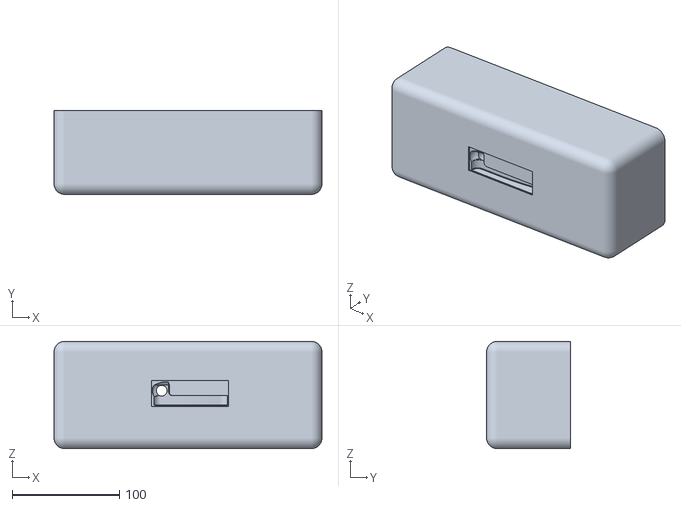
[picture p48: CAD file, 2016-08-12]
jigs/Flexystruder_holder.stl
250.0 x 78.2 x 100.0
