alephobjects/taz-toolhead-kanyu/jigs/Flexystruder_holderV0.6.stl

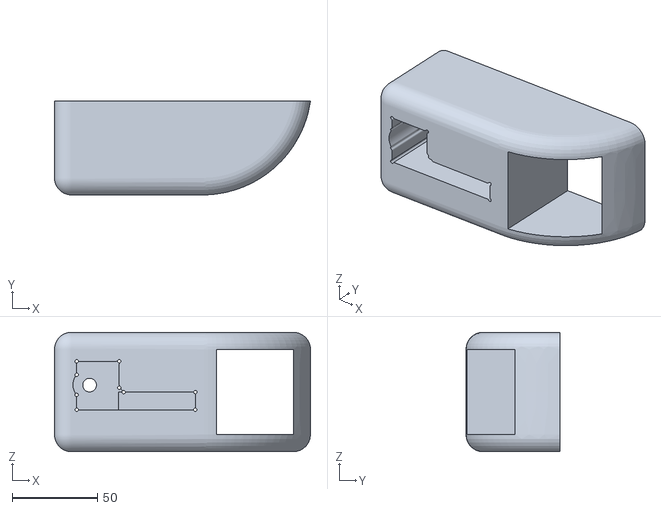
[picture p49: CAD file, 2016-08-12]
jigs/Flexystruder_holderV0.6.stl
150.0 x 55.0 x 70.0
