alephobjects/taz-toolhead-kanyu/production_parts/test_parts/extended_hex_nozzle_v0.15.step

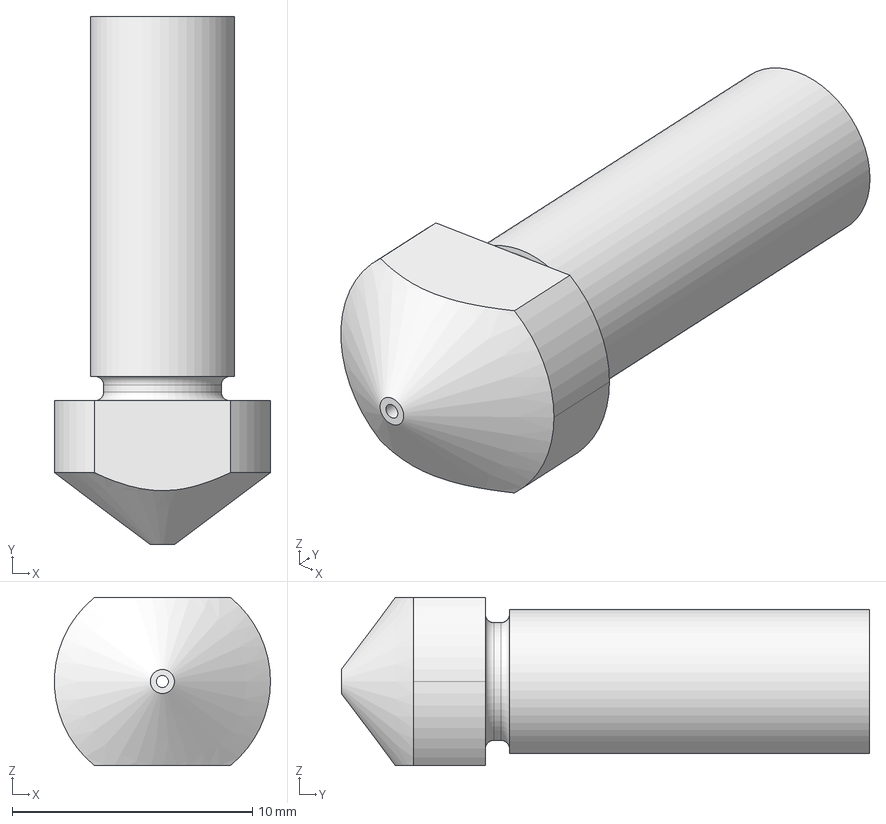
[picture p50: CAD file, 2016-08-12]
production_parts/test_parts/extended_hex_nozzle_v0.15.step
8.99 x 22.0 x 7.00 mm
