alephobjects/taz-toolhead-kanyu/jigs/35-40-65mm_motor_wire_cut_jig_v0.1.FCStd

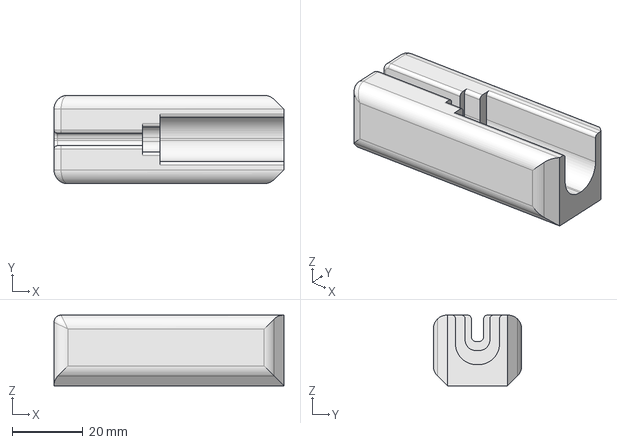
[picture p51: CAD file, 2016-08-12]
jigs/35-40-65mm_motor_wire_cut_jig_v0.1.FCStd
65.0 x 25.0 x 20.0 mm
