alephobjects/taz-toolhead-kanyu/(list of files, cad)

Other CAD files:
flexystruder/flexystruder-1.0/freecad source/Flexystruder_0.6.8.fcstd
flexystruder/Novelties/Spiral_strap.stl
production_parts/test_parts/extended_hex_HB_0.1_drawing.fcstd
production_parts/test_parts/extended_hex_nozzle_0.1_drawing.fcstd
production_parts/test_parts/flexystruder_body_0.7b.stl
flexystruder/Novelties/Bellows.stl
production_parts/test_parts/flexystruder_body_0.8.stl
jigs/200mm_cut_jig_0.1.stl
production_parts/test_parts/flexystruder_body_hex_v2.0.stl
production_parts/test_parts/flexystruder_body_0.75b.stl
jigs/flexystruder_body_holderV0.7.stl
production_parts/test_parts/extended_hex_HB_0.1.fcstd
production_parts/test_parts/flexystruder_body_0.7b_hipoly.stl
production_parts/test_parts/flexystruder_body_0.7.stl
first_print/source_files/lulzbot_TAZ_flexystruder_keychain.blend
flexystruder/Novelties/lulzbotsheet.blend
flexystruder/archive/Flexystruder_0.1/Flexystruder-0.1.stl
flexystruder/archive/Flexystruder_0.2/Archive/Flextstruder_0.2.fcstd
flexystruder/archive/Flexystruder_0.2/Flexystruder_0.2.fcstd
flexystruder/archive/Flexystruder_0.2/Flexystruder_0.2.stl
flexystruder/archive/Flexystruder_0.3/Flexystruder_0.3.fcstd
flexystruder/archive/Flexystruder_0.3/Flexystruder_0.3.stl
flexystruder/archive/Flexystruder_0.3/Flexystruder_0.4.fcstd
flexystruder/archive/Flexystruder_0.3/Flexystruder_0.4.stl
flexystruder/archive/Flexystruder_0.4/Flexystruder_0.4.fcstd
flexystruder/archive/Flexystruder_0.4/Flexystruder_0.4.stl
flexystruder/archive/Flexystruder_0.5/STL_&_G-code/Flexystruder0.5_fixed.stl
flexystruder/archive/Flexystruder_0.5/STL_&_G-code/Flexystruder0.6.stl
flexystruder/archive/Flexystruder_test/Flexystruder_slim.fcstd
flexystruder/archive/Flexystruder_test/flexystruder_s.stl
flexystruder/flexystruder-1.0/freecad source/flexy4dual.blend
flexystruder/flexystruder-1.0/freecad source/flexystruder-V1.1.blend
jigs/Flexystruder_holderV0.1.stl
jigs/Flexystruder_holderV0.3.stl
jigs/Flexystruder_holderV0.4.stl
jigs/Flexystruder_holderV0.5.stl
jigs/harness_holder_bottom_v1.0.stl
jigs/harness_holder_top_v1.0.stl
production_parts/test_parts/extended_hex_HB_0.1.stl
