alephobjects/taz-toolhead-kanyu/flexystruder/production_docs/Flexystruder_Assembly_Instructions.odt

_Flexystruder 0.5 Assembly Instructions

1. Print one flexystruder_0.75
  1. If you're building a new extruder from scratch, you'll need to print 1 extruder washer, 1 large and 1 small herringbone gears. Otherwise, you can scavenge these from another Lulzbot extruder.
2. Install 1 M5 thermal insert into the side of the flexystruder body. The top of the insert should be flush with the surface of the extruder body.
3. Drill out filament hole with a 6.5mm bit. You want it to be tight around the PTFE tube, but too tight and it'll split the body.
4. Drill the PTFE tube to an inner diameter of 3.5mm, then slide onto the shaft of a 2.5mm hex driver (in the Lulzbot toolkit).
5. Starting at the bottom of the extruder body, press the PTFE tube into the extruder body until a small amount is protruding from both top and bottom. Cut these flush with the surfaces.
6. Using an 8mm drillbit, ream out the center hole for the hobbed bolt. You should be cutting mostly through the PTFE, going slower produces a cleaner cut. You may need to ream the top half of the PTFE tube with the 3.5mm drillbit again, as this step tends to close the tube up a bit.
7. Press the M8 hobbed bolt into the larger gear, then stack 4 M8 washers, 1 608ZZ bearing and the printed washer on the hobbed bolt. Press it in to the front of the extruder body (the one that printed flat on the glass).
8. On the other side of the extruder, stack 1 M8 washer, 1 608ZZ bearing, another M8 washer and an M8 locking nut onto the hobbed bolt. Tighten and verify that the hobbed section of the bolt lines up with the PTFE tube.
9. Press 2 M4 hex nuts into the holes on the base of the extruder using pliers or chanel locks.
10. Thread an M3x8 bolt into the threaded insert, only finger tight. Tighten this more only if you are experiencing filament stripping.
11. Attach the small gear to the shaft of a NEMA17 using an M3 hex nut and M3x6 grub screw (the nut slides into the rectangular hole in the bottom of the gear).
12. Using 3 M3x10mm bolts with washers, attach the NEMA17 motor to the extruder body so that the teeth of the larger and smaller gears line up. Make sure that the gears are pressed together tight enough that there is no backlash, but not overly tight.
13. Mount on printer. Print lots of flexy things.
