alephobjects/taz-toolhead-kanyu/production_docs/calibration_guide_TAZ.odt

LULZBOT LOGO AND STUFF

You've bought a flexystruder for your TAZ. Great!

Your unit has been tested and calibrated in the factory, please follow these steps to configure your TAZ for the new toolhead.

- After installing the toolhead, open up cura and connect to the printer. In the dialog box on the right side of the control window, enter:
  - M92 E_____
  - M500

This will adjust the amount of material that the printhead feeds to our factory calibrated value. In the event that you want to switch back to the standard extruder, follow these instructions:

- After installing the new toolhead, open up cura and connect to the printer. In the dialog box on the right side of the control window, enter:
  - M502
  - M500
