alephobjects/taz-toolhead-kanyu/calibration/200mm_estep_table.ods

Extruded amount | E-step Value
185 | 973
186 | 968
187 | 963
188 | 957
189 | 952
190 | 947
191 | 942
192 | 938
193 | 933
194 | 928
195 | 923
196 | 918
197 | 914
198 | 909
199 | 905
200 | 900
201 | 896
202 | 891
203 | 887
204 | 882
205 | 878
206 | 874
207 | 870
208 | 865
209 | 861
210 | 857
