alephobjects/taz-toolhead-kanyu/calibration/200mm_estep_table_base_900.ods

Extruded amount (before lower mark) | E-step Value | Extruded amount (past low mark) | E-step Value
-31 | 976 | 0 | 900
-30 | 973 | 1 | 898
-29 | 970 | 2 | 896
-28 | 968 | 3 | 893
-27 | 965 | 4 | 891
-26 | 963 | 5 | 889
-25 | 960 | 6 | 887
-24 | 957 | 7 | 885
-23 | 955 | 8 | 882
-22 | 952 | 9 | 880
-21 | 950 | 10 | 878
-20 | 947 | 11 | 876
-19 | 945 | 12 | 874
-18 | 942 | 13 | 872
-17 | 940 | 14 | 870
-16 | 938 | 15 | 867
-15 | 935 | 16 | 865
-14 | 933 | 17 | 863
-13 | 930 | 18 | 861
-12 | 928 | 19 | 859
-11 | 925 | 20 | 857
-10 | 923 | 21 | 855
-9 | 921 | 22 | 853
-8 | 918 | 23 | 851
-7 | 916 | 24 | 849
-6 | 914 | 25 | 847
-5 | 911 | 26 | 845
-4 | 909 | 27 | 843
-3 | 907 | 28 | 841
-2 | 905 | 29 | 839
-1 | 902 | 30 | 837
0 | 900 | 31 | 835
 |  | 32 | 833
 |  | 33 | 831
 |  | 34 | 829
 |  | 35 | 828
 |  | 36 | 826
 |  | 37 | 824
 |  | 38 | 822
 |  | 39 | 820
 |  | 40 | 818
