alephobjects/taz-toolhead-kanyu/flexystruder/flexystruder-changelog-credits.odt

Change Log and Credits – Flexystruder

Credits:

The flexystruder is a redesign of Jonas Kuehling’s Greg’s Wade extruder, which has been in use on Lulzbot printers since the AO-100. The design was fully redrawn in freeCAD at Aleph Object’s headquarters (AOHQ) and is released under the GNU/GPL license.

Change Log

- Flexystruder_0.1
  - As originally designed: this is a modified version of Jonas Kuehling’s Greg’s Wade extruder designed to fully constrain the filament in X and Y to prevent flexible filament from buckling. As of 11/26/2013 the design has been tested for over 16 hours with flexible PLA, FilaFlex (thermoplastic urethane) and ABS with no signs of stripping or wear.
- Flexystruder_0.2 (ABANDONED)
  - A full redraw in FreeCAD of version 0.1 to clean up errors in the model. The Filament path was moved 1mm closer to the hobbed bolt to try to improve griping strength and eliminate the need for the side setscrew. 1mm was too much, and several other design changes were necessary. - This version was abandoned in favor of the flexystruder slim (ver0.3)
- Flexystruder_0.3
  - The flexystruder_0.3 started out as the flexystruder-slim, with as much material as possible taken out to lighten the part. A wall of the extruder was also removed to allow access to the hobbed bolt in the event of a filament strip.
- Flexystruder_0.4
- Previous versions had an M3 set screw that pushed against the back of the PTFE tube to increase the bite of the hobbed bolt. If overtightened, this screw stuck through the PTFE tube and into the filament path. Version 0.4 adds an ABS plug between the set screw and the PTFE, preventing over-tightening and widening the contact area of the set screw on the filament tube.
- Flexystruder_0.5
  The M3 set screw still proved problematic, either not pushing the plug evenly, or self tapping into it. The new updated version has an M5 in place of the M3, which seems to be working well without any plugs.
