alephobjects/taz-toolhead-kanyu/software/firmware/Marlin_TAZ45_Kanyu_1.0.0.2/Configuration.h

#define CONFIGURATION_H
#define STRING_VERSION_CONFIG_H __DATE__ " " __TIME__ // build date and time
#define STRING_CONFIG_H_AUTHOR "(Aleph Objects, Inc, FlexyTAZ  config)" // Who made the changes.
#define SERIAL_PORT 0
#define BAUDRATE 115200
#define MOTHERBOARD 301
#define CUSTOM_PRINTER_NAME "Flexy TAZ"
#define EXTRUDERS 1
#define POWER_SUPPLY 1
#define TEMP_SENSOR_0 5
#define TEMP_SENSOR_1 5
#define TEMP_SENSOR_2 0
#define TEMP_SENSOR_BED 7
#define MAX_REDUNDANT_TEMP_SENSOR_DIFF 10
#define TEMP_RESIDENCY_TIME 0.5  // (seconds)
#define TEMP_HYSTERESIS 10       // (degC) range of +/- temperatures considered "close" to the target one
#define TEMP_WINDOW     10       // (degC) Window around target to start the residency timer x degC early.
#define HEATER_0_MINTEMP 5
#define HEATER_1_MINTEMP 5
#define HEATER_2_MINTEMP 5
#define BED_MINTEMP 5
#define HEATER_0_MAXTEMP 305
#define HEATER_1_MAXTEMP 305
#define HEATER_2_MAXTEMP 305
#define BED_MAXTEMP 120
#define PIDTEMP
#define BANG_MAX 220 // limits current to nozzle while in bang-bang mode; 255=full current
#define PID_MAX 225 // limits current to nozzle while PID is active (see PID_FUNCTIONAL_RANGE below); 255=full current
  #define PID_FUNCTIONAL_RANGE 16 // If the temperature difference between the target temperature and the actual temperature
  #define PID_INTEGRAL_DRIVE_MAX 220  //limit for the integral term
  #define K1 0.96 //smoothing factor within the PID
  #define PID_dT ((OVERSAMPLENR * 8.0)/(F_CPU / 64.0 / 256.0)) //sampling period of the temperature routine
    #define  DEFAULT_Kp 28.79
    #define  DEFAULT_Ki 1.91
    #define  DEFAULT_Kd 108.51
#define PIDTEMPBED
#define MAX_BED_POWER 206 // limits duty cycle to bed; 255=full current
    #define  DEFAULT_bedKp 162
    #define  DEFAULT_bedKi 17
    #define  DEFAULT_bedKd 378
#define PREVENT_DANGEROUS_EXTRUDE
#define PREVENT_LENGTHY_EXTRUDE
#define EXTRUDE_MINTEMP 120
#define EXTRUDE_MAXLENGTH (X_MAX_LENGTH+Y_MAX_LENGTH) //prevent extrusion of very large distances.
#define ENDSTOPPULLUPS // Comment this out (using // at the start of the line) to disable the endstop pullup resistors
  #define ENDSTOPPULLUP_XMAX
  #define ENDSTOPPULLUP_YMAX
  #define ENDSTOPPULLUP_ZMAX
  #define ENDSTOPPULLUP_XMIN
  #define ENDSTOPPULLUP_YMIN
  #define ENDSTOPPULLUP_ZMIN
const bool X_MIN_ENDSTOP_INVERTING = true; // set to true to invert the logic of the endstop.
const bool Y_MIN_ENDSTOP_INVERTING = true; // set to true to invert the logic of the endstop.
const bool Z_MIN_ENDSTOP_INVERTING = true; // set to true to invert the logic of the endstop.
const bool X_MAX_ENDSTOP_INVERTING = true; // set to true to invert the logic of the endstop.
const bool Y_MAX_ENDSTOP_INVERTING = true; // set to true to invert the logic of the endstop.
const bool Z_MAX_ENDSTOP_INVERTING = true; // set to true to invert the logic of the endstop.
#define DISABLE_MAX_ENDSTOPS
#if defined(COREXY) && !defined(DISABLE_MAX_ENDSTOPS)
  #define DISABLE_MAX_ENDSTOPS
#endif
#define X_ENABLE_ON 0
#define Y_ENABLE_ON 0
#define Z_ENABLE_ON 0
#define E_ENABLE_ON 0 // For all extruders
#define DISABLE_X false
#define DISABLE_Y false
#define DISABLE_Z false
#define DISABLE_E false // For all extruders
#define INVERT_X_DIR false    // for Mendel set to false, for Orca set to true
#define INVERT_Y_DIR true    // for Mendel set to true, for Orca set to false
#define INVERT_Z_DIR false     // for Mendel set to false, for Orca set to true
#define INVERT_E0_DIR true   // for direct drive extruder v9 set to true, for geared extruder set to false
#define INVERT_E1_DIR true    // for direct drive extruder v9 set to true, for geared extruder set to false
#define INVERT_E2_DIR true   // for direct drive extruder v9 set to true, for geared extruder set to false
#define X_HOME_DIR -1
#define Y_HOME_DIR -1
#define Z_HOME_DIR -1
#define min_software_endstops true // If true, axis won't move to coordinates less than HOME_POS.
#define max_software_endstops true  // If true, axis won't move to coordinates greater than the defined lengths below.
#define X_MAX_POS 298
#define X_MIN_POS 0
#define Y_MAX_POS 275
#define Y_MIN_POS 0
#define Z_MAX_POS 250
#define Z_MIN_POS 0
#define X_MAX_LENGTH (X_MAX_POS - X_MIN_POS)
#define Y_MAX_LENGTH (Y_MAX_POS - Y_MIN_POS)
#define Z_MAX_LENGTH (Z_MAX_POS - Z_MIN_POS)
#define MANUAL_X_HOME_POS 0
#define MANUAL_Y_HOME_POS 0
#define MANUAL_Z_HOME_POS 0
#define NUM_AXIS 4 // The axis order in all axis related arrays is X, Y, Z, E
#define HOMING_FEEDRATE {50*60, 50*60, 8*60, 0}  // set the homing speeds (mm/min)
#define DEFAULT_AXIS_STEPS_PER_UNIT   {100.5,100.5,1600,900}  // default steps per unit for TAZ {X,Y,Z,E}
#define DEFAULT_E1_STEPS_PER_UNIT     800                    // default steps per unit for second extruder
#define DEFAULT_MAX_FEEDRATE          {800, 800, 8, 40}      // (mm/sec)
#define DEFAULT_MAX_ACCELERATION      {9000,9000,100,10000}  // X, Y, Z, E maximum start speed for accelerated moves. E default values are good for skeinforge 40+, for older versions raise them a lot.
#define DEFAULT_ACCELERATION          500    // X, Y, Z and E max acceleration in mm/s^2 for printing moves
#define DEFAULT_RETRACT_ACCELERATION  3000   // X, Y, Z and E max acceleration in mm/s^2 for retracts
#define EXTRUDER_OFFSET_X {0.0, 0.00} // (in mm) for each extruder, offset of the hotend on the X axis
#define EXTRUDER_OFFSET_Y {0.0, -52.00}  // (in mm) for each extruder, offset of the hotend on the Y axis
#define DEFAULT_XYJERK                8.0    // (mm/sec)
#define DEFAULT_ZJERK                 0.4     // (mm/sec)
#define DEFAULT_EJERK                 10.0    // (mm/sec)
#define EEPROM_SETTINGS
#define EEPROM_CHITCHAT
#define NINJA_PREHEAT_HOTEND_TEMP 225
#define NINJA_PREHEAT_HPB_TEMP 60
#define NINJA_PREHEAT_FAN_SPEED 0   // Insert Value between 0 and 255
#define SEMI_PREHEAT_HOTEND_TEMP 225
#define SEMI_PREHEAT_HPB_TEMP 60
#define SEMI_PREHEAT_FAN_SPEED 0   // Insert Value between 0 and 255
#define REPRAP_DISCOUNT_FULL_GRAPHIC_SMART_CONTROLLER
 #define DOGLCD
 #define U8GLIB_ST7920
 #define REPRAP_DISCOUNT_SMART_CONTROLLER
 #define ULTIPANEL
 #define NEWPANEL
  #define SDSUPPORT
  #define ULTRA_LCD
    #define LCD_WIDTH 20
    #define LCD_HEIGHT 5
#  define DEFAULT_LCD_CONTRAST 32
#define FAST_PWM_FAN
#define SOFT_PWM_SCALE 0
#include "Configuration_adv.h"
#include "thermistortables.h"
