alephobjects/taz-toolhead-kanyu/software/firmware/Marlin_TAZ45_Kanyu_1.0.0.2/Configuration_adv.h

#define CASEFAN_PIN FAN2_PIN //Pin used for the fan to cool controller (-1 to disable)
#define ENDSTOPS_ONLY_FOR_HOMING // If defined the endstops will only be used for homing
#define X_HOME_RETRACT_MM 5
#define Y_HOME_RETRACT_MM 5
#define Z_HOME_RETRACT_MM 4
#define QUICK_HOME  //if this is defined, if both x and y are to be homed, a diagonal move will be performed initially.
#define MICROSTEP1 LOW,LOW
#define MICROSTEP2 HIGH,LOW
#define MICROSTEP4 LOW,HIGH
#define MICROSTEP8 HIGH,HIGH
#define MICROSTEP16 HIGH,HIGH
#define MICROSTEP_MODES {16,16,16,16,16} // [1,2,4,8,16]
#define DIGIPOT_MOTOR_CURRENT {175,175,240,135,135} // Values 0-255 (RAMBO 135 = ~0.75A, 185 = ~1A)
