alephobjects/taz-toolhead-kanyu/flexystruder/Marlin_2015Q1_FlexyTAZ5/Arduino/hardware/arduino/cores/robot/WString.cpp

/*
  WString.cpp - String library for Wiring & Arduino
  ...mostly rewritten by Paul Stoffregen...
  Copyright (c) 2009-10 Hernando Barragan.  All rights reserved.
  Copyright 2011, Paul Stoffregen, paul@pjrc.com

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
  You should have received a copy of the GNU Lesser General Public
  License along with this library; if not, write to the Free Software
  Foundation, Inc., 51 Franklin St, Fifth Floor, Boston, MA  02110-1301  USA
*/

#include "WString.h"


/*********************************************/
/*  Constructors                             */
/*********************************************/

String::String(const char *cstr)
{
	init();
	if (cstr) copy(cstr, strlen(cstr));
}

String::String(const String &value)
{
	init();
	*this = value;
}

#ifdef __GXX_EXPERIMENTAL_CXX0X__
String::String(String &&rval)
{
	init();
	move(rval);
}
String::String(StringSumHelper &&rval)
{
	init();
	move(rval);
}
#endif

String::String(char c)
{
	init();
	char buf[2];
	buf[0] = c;
	buf[1] = 0;
	*this = buf;
}

String::String(unsigned char value, unsigned char base)
{
	init();
	char buf[9];
	utoa(value, buf, base);
	*this = buf;
}

String::String(int value, unsigned char base)
{
	init();
	char buf[18];
	itoa(value, buf, base);
	*this = buf;
}

String::String(unsigned int value, unsigned char base)
{
	init();
	char buf[17];
	utoa(value, buf, base);
	*this = buf;
}

String::String(long value, unsigned char base)
{
	init();
	char buf[34];
	ltoa(value, buf, base);
	*this = buf;
}

String::String(unsigned long value, unsigned char base)
{
	init();
	char buf[33];
	ultoa(value, buf, base);
	*this = buf;
}

String::~String()
{
	free(buffer);
}

/*********************************************/
/*  Memory Management                        */
/*********************************************/

inline void String::init(void)
{
	buffer = NULL;
	capacity = 0;
	len = 0;
	flags = 0;
}

void String::invalidate(void)
{
	if (buffer) free(buffer);
	buffer = NULL;
	capacity = len = 0;
}

unsigned char String::reserve(unsigned int size)
{
	if (buffer && capacity >= size) return 1;
	if (changeBuffer(size)) {
		if (len == 0) buffer[0] = 0;
		return 1;
	}
	return 0;
}
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
