alephobjects/taz-toolhead-kanyu/(commit log)

2016-08-12 Defined submodules for the two existing Marlin sub-repos
2016-08-22 Add Marlin v1.0.2.20 submodule
2016-09-07 Increased Max temp range to 290C and incremented firmware version.
    [Configuration.h, Configuration_adv.h]
2016-10-12 Add Multi-level BOM aka MBOM to project
    [kanyu_v2.0D_MBOM.ods]
