alephobjects/taz-toolhead-kanyu/flexystruder/images/OHAI/IMG_0163.JPG

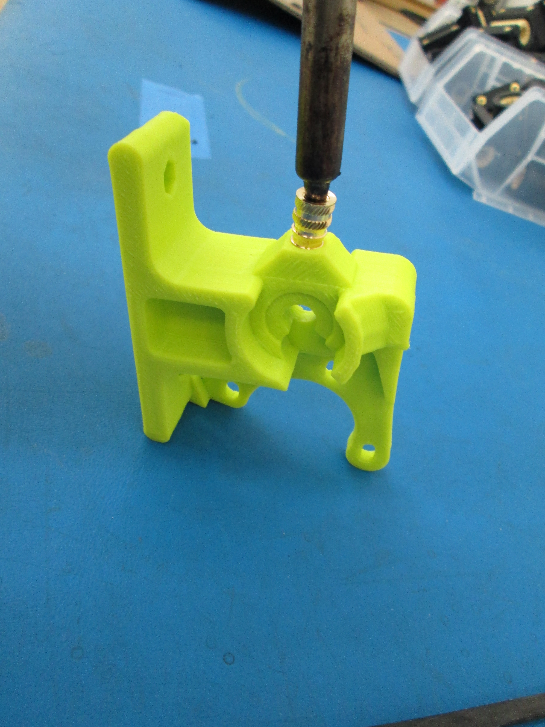
flexystruder/images/OHAI/IMG_0163.JPG
